huydinhischanging/mini-automotive-ecu-uds/README.md

# Mini Automotive ECU Network with UDS Diagnostics



A scaled-down model of an in-vehicle network: several ECUs talk over CAN, detect faults,
store diagnostic trouble codes (DTCs) and answer a diagnostic tester using **UDS (ISO 14229)**
over **ISO-TP (ISO 15765-2)**.

> 🚧 Work in progress. See [Roadmap](#roadmap) for current status.

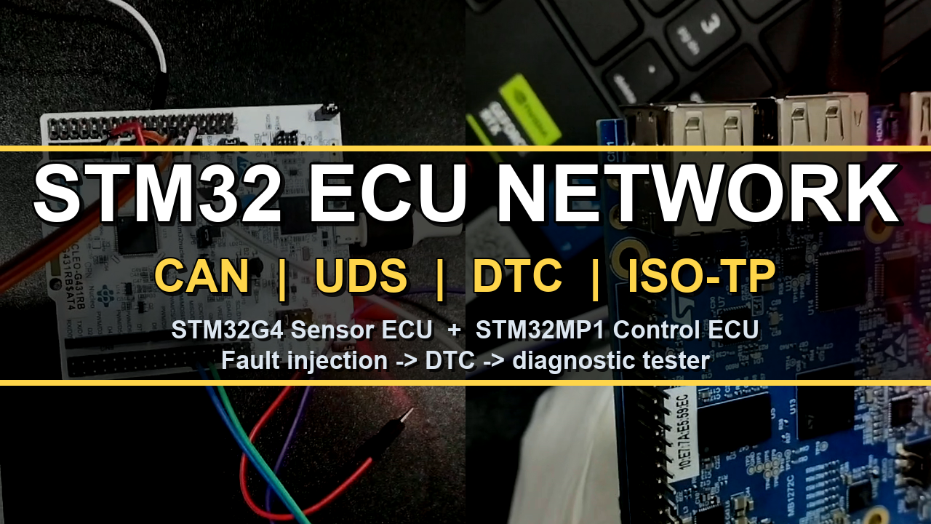
[picture p1: docs/images/demo_thumbnail.png]
Demo video: STM32 ECU network with CAN, UDS, DTC and ISO-TP (https://www.youtube.com/watch?v=Ocq1K0BO8kM)


▶ **Demo video (3 min):** https://www.youtube.com/watch?v=Ocq1K0BO8kM

> 📄 Technical report (milestones M1–M5): [docs/report/main.pdf](docs/report/main.pdf)

## System overview

```
 ┌──────────────────┐        CAN 500 kbit/s (Classic 2.0A)        ┌────────────────────────┐
 │  Sensor ECU      │═════════╦══════════════════════╦═════════════│  Control ECU           │
 │  NUCLEO-G431RB   │  0x100  ║                      ║  0x7E8      │  STM32MP157 Cortex-M4  │
 │  pot → ADC → CAN │  0x101  ║                      ║             │  FreeRTOS, DTC, UDS    │
 └──────────────────┘         ║                      ║             └────────────────────────┘
                              ║  0x7E0               ║
                     ┌────────╨──────────────────────╨───┐
                     │  Diagnostic Tester                │
                     │  today: UDS tester app on the     │
                     │  Sensor ECU (keys on its VCP)     │
                     └───────────────────────────────────┘
```

| Node | Hardware | Role |
|---|---|---|
| Sensor ECU | NUCLEO-G431RB + SN65HVD230 | Samples a potentiometer (simulated vehicle speed), sends it every 10 ms; also hosts the UDS tester (M5) |
| Control ECU | STM32MP157D-DK1, Cortex-M4 | Receives data, drives outputs, monitors faults, stores DTCs, UDS server |
| Tester (next) | STM32MP157D-DK1, Cortex-A7 (Linux) | C++ UDS client reaching the Control ECU over RPMsg (in progress) |

## CAN matrix

| ID | Sender → Receiver | Cycle | Content |
|---|---|---|---|
| `0x100` | Sensor → bus | 10 ms | Speed (0.1 km/h), raw ADC, status, alive counter, CRC-8 |
| `0x101` | Sensor → bus | 100 ms | Node state, uptime, bus-off count, alive counter, CRC-8 |
| `0x200` | Control ECU → bus | 100 ms | active faults, confirmed DTC count, output duty, alive counter, CRC-8 |
| `0x7E0` | Tester → Control ECU | on request | UDS request |
| `0x7E8` | Control ECU → Tester | on request | UDS response |

Signal-level layout: [`common/can/can_matrix.h`](common/can/can_matrix.h), compiled by both ECUs.
Cyclic frames carry an alive counter and a CRC-8 SAE-J1850 (same as AUTOSAR E2E Profile 1)
so the receiver can detect lost, repeated or corrupted frames.

**Bit timing:** 500 kbit/s, FDCAN kernel clock 170 MHz (from 24 MHz HSE crystal),
prescaler 10, 34 tq/bit (Seg1 29, Seg2 4, SJW 4) → sample point ≈ 88 %.

## Software architecture

Layered, AUTOSAR-inspired. Only the MCAL layer touches the HAL/registers.

```
Application    sensor_app, tester_app / control_app, diag_app
Services       uds_server, dtc_manager           (hardware independent)
Communication  isotp, e2e, crc8, can_matrix      (hardware independent)
MCAL           Sensor: can_drv, adc_drv, gpio_drv, uart_drv, time_drv
               Control: can_drv, io_drv, sys_drv
```

Hardware-independent modules (ISO-TP, UDS, DTC manager) are plain C so they can be unit
tested on a PC.

## UDS services (Control ECU, physical 0x7E0 / functional 0x7DF -> 0x7E8)

| SID | Service | Implemented |
|---|---|---|
| `0x10` | Diagnostic Session Control | `01` default, `03` extended; P2 = 50 ms, P2* = 5 s, S3 = 5 s |
| `0x11` | ECU Reset | `01` hard (firmware restart from the reset vector), `03` soft (new operation cycle); extended session only |
| `0x14` | Clear Diagnostic Information | group `FFFFFF` |
| `0x19` | Read DTC Information | `01` number of DTCs by status mask, `02` DTCs by status mask |
| `0x22` | Read Data By Identifier | `F195` SW version, `0100` speed, `0101` active faults; several DIDs per request |
| `0x3E` | Tester Present | `00`, with suppress-positive-response bit |

Negative responses `0x11`, `0x12`, `0x13`, `0x14`, `0x31`, `0x7E`, `0x7F`; for functional
requests the NRCs required by ISO 14229 are suppressed.

| Fault (monitor) | DTC | Confirmed after |
|---|---|---|
| Speed signal timeout | `U0100-87` (`C10087`) | 1 failed cycle |
| Speed out of range | `P0501-00` (`050100`) | 3 consecutive cycles |
| E2E error on 0x100 | `U0400-81` (`C40081`) | 3 |
| Sensor ADC error | `P0500-96` (`050096`) | 3 |
| Local output fault (USER1) | `B1A00-11` (`9A0011`) | 3 |

DTC status bits follow ISO 14229-1 Annex D (availability mask `0x7F`). Codes use the SAE J2012
layout; the mapping is project specific.

## Repository layout

```
sensor_ecu/          STM32CubeIDE project, NUCLEO-G431RB
  Core/Mcal/         can_drv, adc_drv, gpio_drv, uart_drv, time_drv
  Core/App/          sensor_app, tester_app (UDS tester)
control_ecu/CM4/     STM32MP157 Cortex-M4 firmware (FreeRTOS), loaded by Linux remoteproc
  Core/Mcal/         can_drv, io_drv (PWM output, USER1 button), sys_drv (restart)
  Core/App/          control_app, diag_app (ISO-TP link, UDS, DTC table)
  OPENAMP/           CubeMX-generated RPMsg glue (IPCC mailbox, resource table)
common/can/          CAN matrix shared by all nodes
common/e2e/          alive counter + CRC-8 protection (sender and receiver)
common/isotp/        ISO 15765-2 transport layer (SF/FF/CF/FC, BS, STmin, N_Bs/N_Cr timeouts)
common/uds/          UDS server (ISO 14229-1)
common/dtc/          DTC manager with ISO 14229 status bits
tests/               host unit tests (make)
tester/              C++20 UDS client, simulated ECU, GoogleTest (CMake)
tools/               check_all.sh, static_analysis.sh, arm_compile_check.sh, MISRA suppressions
docs/                report (LaTeX + PDF), logs, MISRA deviations, images
```

## Wiring (verified)

| Signal | NUCLEO-G431RB | SN65HVD230 | STM32MP157D-DK1 |
|---|---|---|---|
| FDCAN1_TX | PA12 = CN10 pin 12 (morpho) | CTX | PA12 = CN13 pin 9 (Arduino D14) |
| FDCAN1_RX | PA11 = CN10 pin 14 (morpho) | CRX | PA11 = CN13 pin 10 (Arduino D15) |
| Supply | 3V3 / GND (CN6) | 3V3 / GND | 3V3 = CN16 pin 4, GND = CN16 pin 6 |

Bus: CANH–CANH, CANL–CANL (twisted pair) and a common GND between both boards.
Each module carries a 120 Ω terminator, so CANH–CANL measures about 60 Ω with both connected.
On the DK1 use D14/D15 on CN13, not A4/A5; the same signals are also on the 40-pin CN2 (pins 3 and 5).

## Building and running the Sensor ECU

1. STM32CubeIDE → *File → Import → Existing Projects into Workspace* → select `sensor_ecu/`.
2. Build, then flash with the on-board ST-LINK.
3. Open the ST-LINK virtual COM port at 115200 8N1. A status line is printed every second:
   ```
   [SENSOR] speed=123.4 km/h adc=2021 mode=0 | tx=110 drop=0 rx=110 rx100=100 busoff=0
   ```

`SENSOR_APP_CAN_LOOPBACK` in `sensor_app.c` selects FDCAN internal loopback (no transceiver
needed) or normal mode (real bus).

**Fault injection:** the blue user button B1 cycles through
`NONE` → `SILENT` (stop sending 0x100, triggers timeout DTC) → `OUT_OF_RANGE` (300 km/h, triggers range DTC).

## Unit tests

Hardware-independent modules are tested on the PC with fake CAN driver and clock:

```
cd tests
make          # needs gcc (Linux, or MSYS2 UCRT64 on Windows)
```

## C++ UDS tester (`tester/`)

A UDS client in C++20 that will run on the DK1's Linux side and reach the Control ECU over
RPMsg. The client talks to an `ITransport` interface, so the same code runs against:

- `SimulatedEcu`: the **real C UDS server and DTC manager from `common/`** linked into the host
  program, so the client is tested against the code that runs on the M4;
- `RpmsgTransport` on the DK1 (next step).

```
cmake -S tester -B tester/build -G Ninja && cmake --build tester/build
ctest --test-dir tester/build          # GoogleTest
tester/build/uds_tester --sim          # same scenario as the M5 tester, against SimulatedEcu
```

GitHub Actions builds and runs the C unit tests (UBSan) and the C++ tests (ASan + UBSan) on
every push.

## Static analysis (cppcheck + MISRA C:2012)

Run all host checks (unit tests, static analysis, and a compile of both firmwares with
`arm-none-eabi-gcc`) in one go: `tools/check_all.sh`. The compile step uses the toolchain bundled
with STM32CubeIDE and is skipped if none is found; it can also be run on its own:
`tools/arm_compile_check.sh [FILE.c ...]`.

```
tools/static_analysis.sh      # cppcheck 2.x with the MISRA addon, exit 1 on findings
```

All project code (`common/`, App and MCAL layers of both ECUs) passes with **no findings**.
Nine rule violations were fixed in the code; the six remaining deviations (D1–D6) are documented in
[docs/misra_deviations.md](docs/misra_deviations.md).

## Milestones

### M1 — Sensor ECU bring-up (FDCAN internal loopback) ✅

NUCLEO-G431RB samples the potentiometer and publishes `0x100` (10 ms) and `0x101` (100 ms).
In FDCAN internal loopback the controller receives its own frames, which verifies bit-timing
configuration, acceptance filter, RX interrupt and frame packing without a transceiver.

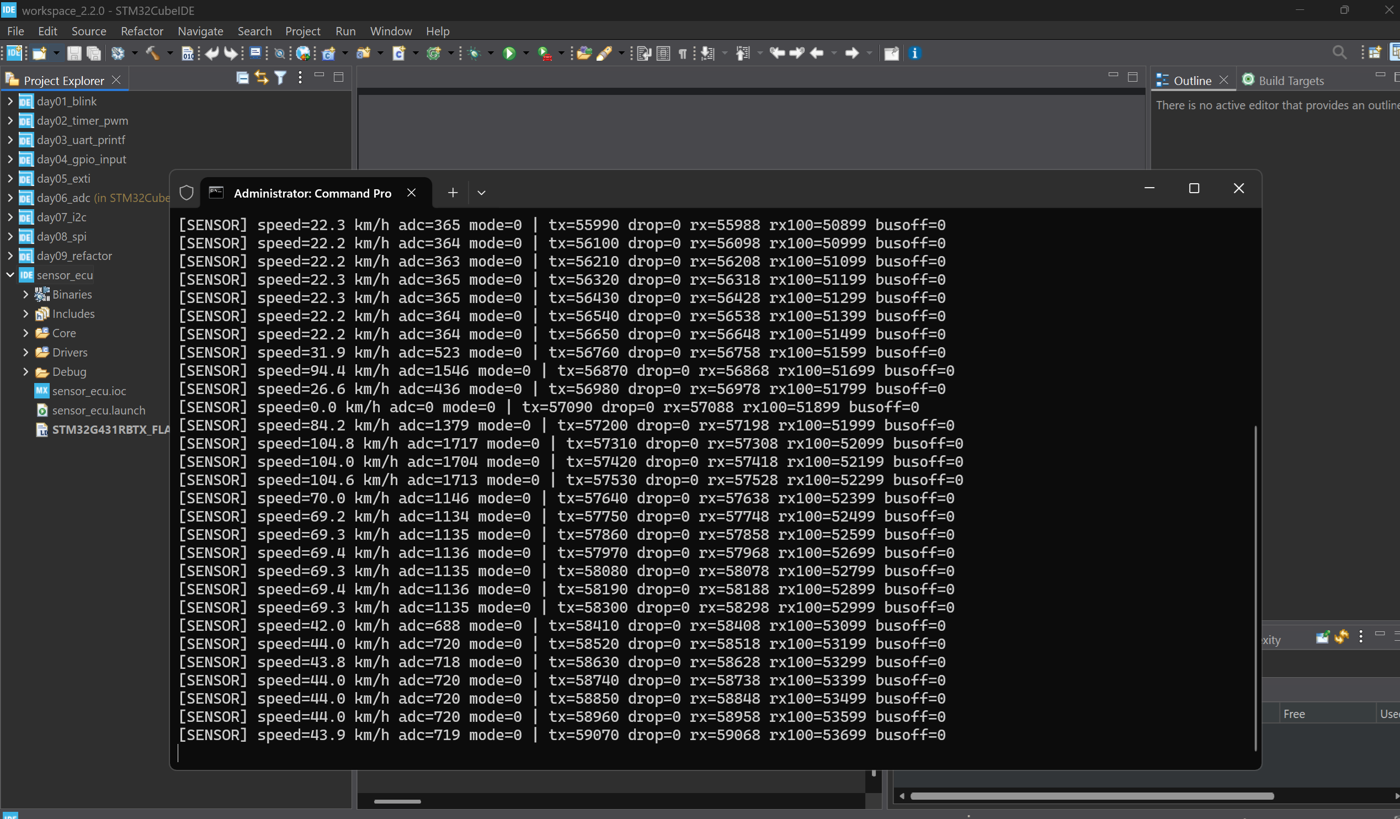
[picture p2: docs/images/m1_sensor_loopback_uart.png]
Sensor ECU UART log in internal loopback


| Check | Result |
|---|---|
| TX rate | 110 frames/s (100 × `0x100` + 10 × `0x101`) as designed |
| RX in loopback | every `0x100` received back (`rx100` +100/s) |
| Long run | 59 000+ frames, 0 dropped, 0 bus-off |
| ADC | full sweep follows the potentiometer, ±1–2 LSB noise at rest |
| Fault injection (B1) | verified on the real bus in M4 |

### M2 — Control ECU bring-up on the STM32MP157 Cortex-M4 (FDCAN internal loopback) ✅

The M4 firmware is loaded by Linux (remoteproc). In loopback it plays the Sensor ECU
(speed ramp 0–250 km/h) so the full receive chain is exercised on the DK1 alone:
FDCAN ISR → RTOS queue → E2E check → fault monitor → PWM output.

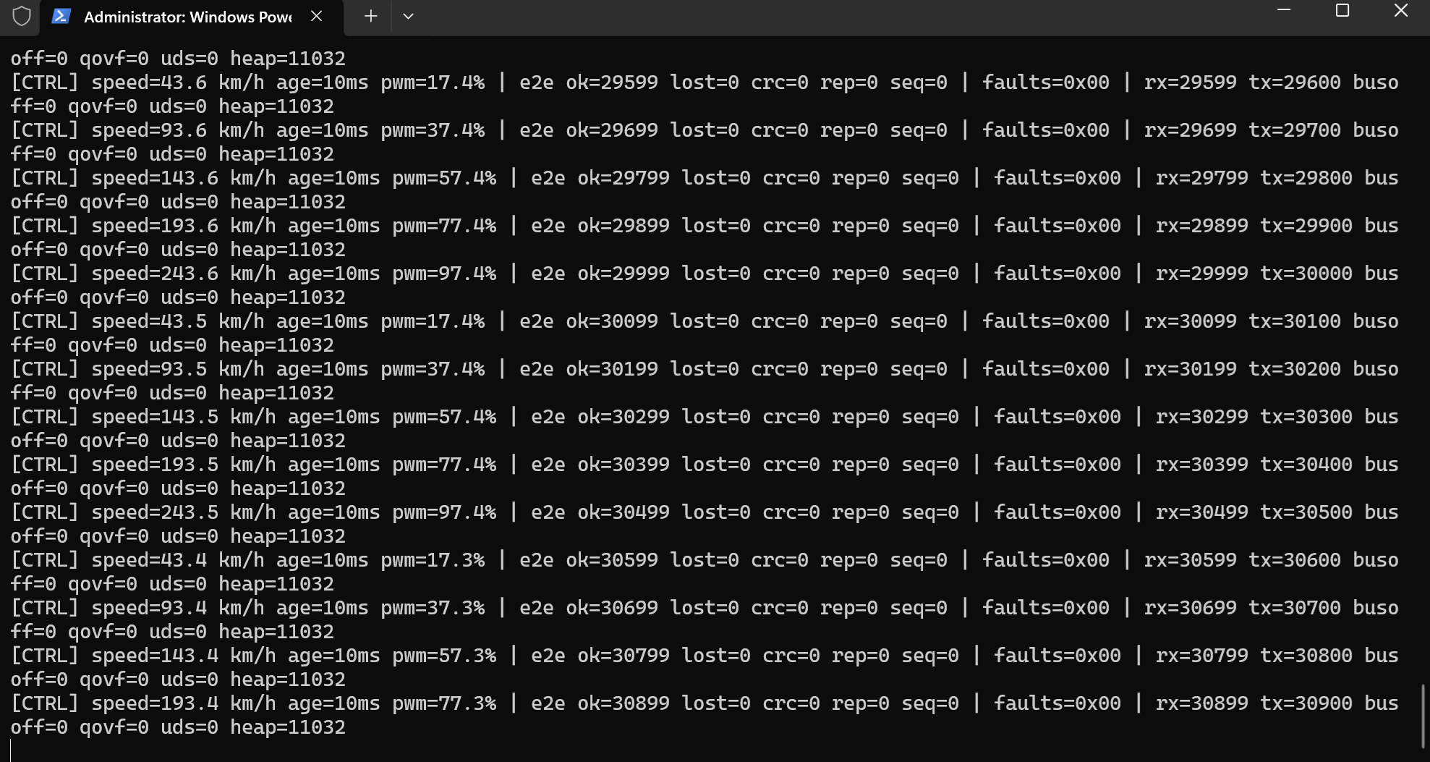
[picture p3: docs/images/m2_control_loopback_uart.png]
Control ECU UART log in internal loopback


| Check | Result |
|---|---|
| Throughput | 100 frames/s received, `rx = tx − 1` (last frame in flight) |
| Long run | 30 900 frames, 0 CRC / 0 lost / 0 repeated / 0 sequence errors |
| RTOS | 0 queue overflows, 11 KB of 16 KB heap free |
| Output | PWM follows speed (e.g. 193.4 km/h → 77.3 %), no active faults |
| Bring-up fixes | FreeRTOS SysTick handler, FDCAN glitch-free clock mux (see below) |

### M3 — UDS diagnostics and DTC management on the Control ECU (FDCAN internal loopback) ✅

A second ISO-TP link on the M4 plays the tester (TX 0x7E0, RX 0x7E8, BS 2, STmin 1 ms) and runs
14 UDS requests over the CAN controller, checking every response. Full log:
[docs/logs/m3_uds_selftest.log](docs/logs/m3_uds_selftest.log)

```
[TEST]  2/14 ReadDID F195 (ECU sends FF+CF)   PASS
[TEST]  3/14 ReadDID x4 (ECU receives FF+CF)  PASS
[TEST]  6/14 Reset in default -> NRC 7E       PASS
[CTRL] fault OUTPUT_LOCAL  SET
[TEST]  9/14 Confirmed DTCs = 1               PASS
[TEST] 10/14 DTC list B1A00-11 0x2F           PASS
[TEST] 11/14 Clear all DTCs                   PASS
[TEST] UDS self-test finished: 14/14 passed
```

Sensor data kept flowing during the test with 0 E2E errors and 0 queue overflows.

### M4 — Two-node CAN bus with fault injection ✅

NUCLEO-G431RB and STM32MP157D-DK1 on a real bus through two SN65HVD230 transceivers.
65 s capture of both ECUs, logs: [sensor](docs/logs/m4_bus_fault_injection_sensor.log),
[control](docs/logs/m4_bus_fault_injection_control.log)

| Time | Sensor ECU | Control ECU |
|---|---|---|
| 23–33 s | potentiometer sweep 142–233 km/h | speed and PWM follow |
| 39.7 s | B1 → `SILENT` (0x100 stopped) | 39.8 s `SPEED_TIMEOUT SET`, PWM 0 %, DTC U0100-87 |
| 46.7 s | B1 → `OUT_OF_RANGE` (300 km/h) | `SPEED_TIMEOUT cleared`, `SPEED_RANGE SET`, PWM 0 %, DTC P0501-00 |
| 55.6 s | B1 → normal | `SPEED_RANGE cleared`, PWM back to 64.5 %, DTCs retained |
| whole run | no dropped frame | 0 CRC / lost / repeated errors, 0 bus-off, 0 queue overflows |

Bring-up of the bus was diagnosed from the FDCAN error registers of both nodes: each node reading
back its own frames (LEC = ACK error) proved the MCU-transceiver wiring on each side, and putting the
DK1 into bus-monitoring (listen-only) mode proved that the bus polarity was correct.

### M5 — External UDS tester on the bus ✅

The Sensor ECU doubles as a UDS tester (shared ISO-TP module, TX 0x7E0 / RX 0x7E8), driven by
single keys on its ST-LINK virtual COM port (`t` test, `d` DTCs, `c` clear, `v` version+speed,
`f` functional 0x7DF, `r` hard reset). All **22 steps passed** over the physical bus; logs:
[tester](docs/logs/m5_uds_tester_sensor.log), [control ECU](docs/logs/m5_uds_tester_control.log).

```
[TESTER]  3/12 ReadDID 0100 speed                     PASS
        Control ECU speed 161.3 km/h, Sensor ECU sends 161.3 km/h
[TESTER]  8/12 Read all DTCs                          PASS
        2 DTC(s)
        U0100-87  status 0x2E pending confirmed
        U0400-81  status 0x2E pending confirmed
[TESTER]  2/2 Functional unknown service: silent     PASS
[TESTER]  2/4 ECUReset hard                          PASS
[TESTER]  3/4 ECU back: TesterPresent (after 3 s)    PASS
```

Hard reset finding: on the STM32MP157 in production mode, `NVIC_SystemReset()` leaves the M4 held
in reset (`RCC_MP_GCR.BOOT_MCU = 0`) because Linux owns its life cycle and is not informed. UDS
`0x11 01` therefore restarts the firmware from the reset vector (`SysDrv_Restart`) after resetting
the M4 peripherals, without resetting the core.

## Bring-up notes (STM32MP157 Cortex-M4)

Issues found while bringing up the Control ECU in production mode (Linux on the A7
starts the M4 through remoteproc). Diagnosed by reading M4 RAM and peripheral
registers from Linux (`/dev/mem`), without a debugger.

| Symptom | Root cause | Fix |
|---|---|---|
| FreeRTOS hangs on the first tick (`xTickCount = 0`) | CubeMX sets `USE_CUSTOM_SYSTICK_HANDLER_IMPLEMENTATION = 1` but generates no `SysTick_Handler` when TIM7 is the HAL timebase, so SysTick lands in `Default_Handler` | Override to `0` in the USER CODE section of `FreeRTOSConfig.h` so `cmsis_os2.c` provides the handler |
| FDCAN never leaves INIT (`CCCR.INIT` stuck at 1, even when cleared from Linux) | Linux leaves the FDCAN kernel mux on PLL4_R with that PLL output disabled. Kernel muxes are glitch-free and only switch while *both* inputs run, so the switch to HSE never completed | `CanDrv_PrepareKernelClock()`: enable HSE kernel output, briefly enable the old PLL output during the switch, restore it afterwards, read back the result |

Known open points:
- HAL tick (TIM7) runs at 2 kHz in production mode: the timer clock set by Linux differs
  from the CubeMX assumption. The application uses the FreeRTOS tick (correct 1 kHz).
- M4 log goes to UART7 (Arduino D0/D1). A remoteproc trace buffer (log readable over SSH)
  is planned as a cable-free alternative.

## Roadmap

- [x] Sensor ECU: CubeMX setup (170 MHz from HSE, FDCAN 500 kbit/s, ADC, TIM6 10 ms tick)
- [x] Sensor ECU: MCAL drivers, cyclic 0x100/0x101 with alive counter + CRC, bus-off recovery
- [x] Sensor ECU: verified in FDCAN internal loopback (M1)
- [ ] Sensor ECU: verify on the real bus with a logic analyzer
- [x] Control ECU: M4 firmware on OpenSTLinux (remoteproc), FDCAN owned by M4, FreeRTOS tasks,
      E2E check, timeout/range faults, safe-state PWM — verified in FDCAN internal loopback
- [x] M3: UDS server + DTC manager on the Control ECU, 14/14 on-target UDS self-test in loopback
- [x] M4: two-node bus, 100 frames/s with 0 E2E errors, 0x200 status back to the Sensor ECU, fault injection -> DTCs
- [ ] Logic analyzer capture of bit timing on the bus
- [ ] E2E fault injection on the Sensor ECU (corrupted CRC, repeated counter, counter jump) to exercise
      the Control ECU's E2E monitor and DTC `U0400-81` on the bus
- [x] ISO-TP (SF, FF, CF, FC, block size, STmin, timeouts) with 26 host unit tests
- [x] UDS server with services above (11 host unit tests)
- [x] DTC manager (ISO 14229 status bits, debounce, operation cycle; 11 host unit tests)
- [x] M5: external UDS tester on the Sensor ECU, 22/22 steps over the bus incl. hard reset
- [x] C++ UDS client (C++20, CMake, GoogleTest) verified against the real UDS server in simulation
- [ ] C++ UDS tester on Linux (Cortex-A7) over RPMsg: IPCC + OpenAMP enabled on the M4, RPMsg bridge next
- [x] Host unit tests: 56 tests / 277 checks (ISO-TP, E2E, DTC, UDS)
- [x] cppcheck + MISRA C:2012 addon: no findings, deviations documented
- [x] Demo video: https://www.youtube.com/watch?v=Ocq1K0BO8kM
