huydinhischanging/mini-automotive-ecu-uds/docs/report/before_main/title.tex

\begin{titlepage}
    \begin{center}
        \vspace*{2.5cm}

        \Large
        PERSONAL PROJECT REPORT

        \vspace{2.0cm}

        \Huge
        \textbf{Mini Automotive ECU Network with UDS Diagnostics}\\[0.8cm]
        \Large
        CAN communication, end-to-end protection and ISO-TP on an\\
        STM32G4 Sensor ECU and an STM32MP157 Control ECU

        \vspace{2.4cm}

        \Large
        By\\
        \textbf{Tu Dinh Huy}

        \vspace{1.2cm}

        \large
        Interim report -- milestones M1 to M5\\[0.3cm]
        Source code: \url{https://github.com/huydinhischanging/mini-automotive-ecu-uds}\\[0.1cm]
        Demo video: \url{https://www.youtube.com/watch?v=Ocq1K0BO8kM}

        \vfill
        Ho Chi Minh City, Vietnam\\
        September 2026

    \end{center}
\end{titlepage}
