huydinhischanging/mini-automotive-ecu-uds/docs/report/before_main/abstract.tex

\chapter*{ABSTRACT}
\addcontentsline{toc}{chapter}{ABSTRACT}

This report describes the design and the first four milestones of a scaled-down in-vehicle network built from low-cost development boards. A \textit{Sensor ECU} on an STM32G431 (NUCLEO-G431RB) samples a potentiometer that emulates vehicle speed and publishes it on a 500\,kbit/s classic CAN bus every 10\,ms. A \textit{Control ECU} runs FreeRTOS on the Cortex-M4 core of an STM32MP157D (STM32MP157D-DK1), next to Linux on the Cortex-A7 cores, and consumes the signal, monitors it for faults and drives a PWM output. A diagnostic tester using UDS (ISO~14229) over ISO-TP (ISO~15765-2) completes the target architecture.

The software follows an AUTOSAR-inspired layering in which only the MCAL layer touches the vendor HAL. Protocol and service modules (ISO-TP, end-to-end protection with an alive counter and CRC-8 SAE-J1850, a UDS server and a DTC manager with ISO~14229 status bits) are written in portable C and are tested on a PC with a small test harness: 56 unit tests with 277 checks pass, including a 4095-byte ISO-TP transfer between two protocol instances.

Both ECUs were verified on hardware in FDCAN internal loopback. The Sensor ECU sent more than 59\,000 frames at the designed 110\,frames/s with no dropped frame and no bus-off; the ADC reading was stable to $\pm$1--2\,LSB. The Control ECU processed 30\,900 frames with zero CRC, sequence or queue-overflow errors while its output tracked the received speed. Bringing up the Control ECU uncovered two platform issues that were diagnosed by reading M4 memory and peripheral registers from Linux, without a hardware debugger: a SysTick handler missing from STM32CubeMX-generated code, and an FDCAN kernel clock stuck in a glitch-free multiplexer whose previous input had been disabled by Linux.

The diagnostic stack was then integrated on the Control ECU: monitor results become DTCs, and a tester running on the same Cortex-M4 exchanged 14 UDS requests with the ECU over the CAN controller, covering segmented ISO-TP transfers in both directions, negative responses, session handling and reading and clearing a confirmed DTC; all 14 passed on hardware.

Finally, both ECUs were connected through SN65HVD230 transceivers. On the physical bus the Control ECU received 100 frames/s with zero end-to-end errors and no bus-off, detected an injected loss of the speed signal within about 100\,ms and an out-of-range value immediately, drove its output to the safe state and stored the corresponding DTCs, which remained stored after the faults healed. An external UDS tester running on the Sensor ECU then exercised the Control ECU over the physical bus in 22 steps, all passing, including a hard reset; this uncovered that a Cortex-M4 system reset on the STM32MP157 leaves the core held in reset under Linux, which was solved with a software restart from the reset vector. The remaining work is a Linux-side tester and a logic-analyser measurement of the bus timing.

\bigskip
\noindent\textbf{Keywords:} Controller Area Network, ISO-TP, UDS, DTC, AUTOSAR E2E, STM32MP157, FreeRTOS, embedded C, unit testing.
\newpage
