huydinhischanging/mini-automotive-ecu-uds/docs/report/before_main/abbreviations.tex

\chapter*{LIST OF ABBREVIATIONS}
\addcontentsline{toc}{chapter}{LIST OF ABBREVIATIONS}

{\small
\renewcommand{\arraystretch}{0.9}
\begin{longtable}{@{}p{3.2cm} p{11cm}@{}}
\textbf{ACK}      & Acknowledge (CAN bit acknowledging a correctly received frame) \\
\textbf{ADC}      & Analog-to-Digital Converter \\
\textbf{AUTOSAR}  & AUTomotive Open System ARchitecture \\
\textbf{BS}       & Block Size (ISO-TP flow-control parameter) \\
\textbf{CAN}      & Controller Area Network \\
\textbf{CCU}      & Clock Calibration Unit (of FDCAN1 on the STM32MP1) \\
\textbf{CF}       & Consecutive Frame (ISO-TP) \\
\textbf{CRC}      & Cyclic Redundancy Check \\
\textbf{DLC}      & Data Length Code \\
\textbf{DTC}      & Diagnostic Trouble Code \\
\textbf{E2E}      & End-to-End (communication protection) \\
\textbf{ECU}      & Electronic Control Unit \\
\textbf{FC}       & Flow Control frame (ISO-TP) \\
\textbf{FDCAN}    & Flexible Data-rate CAN controller (ST implementation of Bosch M\_CAN) \\
\textbf{FF}       & First Frame (ISO-TP) \\
\textbf{HAL}      & Hardware Abstraction Layer (STM32Cube) \\
\textbf{HSE}      & High-Speed External oscillator \\
\textbf{HSI}      & High-Speed Internal RC oscillator \\
\textbf{ISO-TP}   & ISO 15765-2 transport protocol \\
\textbf{ISR}      & Interrupt Service Routine \\
\textbf{LSB}      & Least Significant Bit \\
\textbf{MCAL}     & Microcontroller Abstraction Layer (AUTOSAR) \\
\textbf{MCU}      & Microcontroller Unit \\
\textbf{MPU}      & Microprocessor Unit \\
\textbf{NBT}      & Nominal Bit Time, in time quanta \\
\textbf{NRC}      & Negative Response Code (UDS) \\
\textbf{PLL}      & Phase-Locked Loop \\
\textbf{PWM}      & Pulse-Width Modulation \\
\textbf{RTOS}     & Real-Time Operating System \\
\textbf{SF}       & Single Frame (ISO-TP) \\
\textbf{SJW}      & Synchronisation Jump Width \\
\textbf{SP}       & Sample Point \\
\textbf{STmin}    & Minimum Separation Time between consecutive frames (ISO-TP) \\
\textbf{tq}       & Time quantum \\
\textbf{UART}     & Universal Asynchronous Receiver-Transmitter \\
\textbf{UDS}      & Unified Diagnostic Services (ISO 14229) \\
\end{longtable}
}
\pagebreak
