huydinhischanging/mini-automotive-ecu-uds/docs/report/main.pdf

## PERSONAL PROJECT REPORT

# Mini Automotive ECU Network with UDS Diagnostics

## CAN communication, end-to-end protection and ISO-TP on an STM32G4 Sensor ECU and an STM32MP157 Control ECU

By

## Tu Dinh Huy

### Interim report – milestones M1 to M5

### Source code: https://github.com/huydinhischanging/mini-automotive-ecu-uds Demo video: https://www.youtube.com/watch?v=Ocq1K0BO8kM

### Ho Chi Minh City, Vietnam September 2026

# TABLE OF CONTENTS

LIST OF FIGURES | 3
LIST OF TABLES | 4
LIST OF ABBREVIATIONS | 5
ABSTRACT | 6
1 INTRODUCTION | 7
2 TECHNICAL BACKGROUND | 9
3 SYSTEM DESIGN | 12

4 IMPLEMENTATION AND RESULTS | 20

4.9.2 Issue 2: FDCAN kernel clock stuck in a glitch-free multiplexer . . . 28

5 DISCUSSION AND EVALUATION | 30
6 CONCLUSION AND FUTURE WORK | 33
REFERENCES | 35
Appendices | 36
A Frame Layouts | 36
B Build, Deployment and Diagnosis Procedures | 37

# LIST OF FIGURES

2.1 | Segmented ISO-TP transfer of a 20-byte message | 10
3.1 | Target network architecture. The dashed tester link is future work | 13
3.2 | AUTOSAR-inspired software layers | 15
3.3 | Control ECU data flow | 16
4.1 | Sensor ECU log in FDCAN internal loopback (one line per second) | 22
4.2 | Control ECU log on the STM32MP157 Cortex-M4 in FDCAN internal loopback 23

# LIST OF TABLES

1.1 | Project status at the time of writing | | 8
3.1 | System requirements | 12
3.2 | Hardware | 13
3.3 | Bit-timing configuration (500 kbit/s) | 13
3.4 | CAN matrix | 14
3.5 | Faults monitored by the Control ECU | 16
3.6 | Implemented UDS services | 17
3.7 | DTC mapping of the Control ECU | 18
4.1 | Tools | 20
4.2 | Unit test results | 21
4.3 | Milestone M1 results | 22
4.4 | Milestone M2 results | 23
4.5 | Milestone M3 results | 24
4.6 | Verified bus wiring | 24
4.7 | Milestone M4: fault injection over the physical bus | 25
4.8 | Milestone M5: UDS from an external node | 26
4.9 | Handling of the static-analysis findings | 27
4.10 FDCAN clock state left by Linux after boot | 28
4.11 Memory footprint (Debug builds) | 29
5.1 Requirement coverage | 30
A.1 Frame 0x100 SENSOR_SPEED (DLC 8, 10 ms) | 36
A.2 Frame 0x101 SENSOR_ALIVE (DLC 8, 100 ms) | 36

# LIST OF ABBREVIATIONS

ACK | Acknowledge (CAN bit acknowledging a correctly received frame)
ADC | Analog-to-Digital Converter
AUTOSAR | AUTomotive Open System ARchitecture
BS | Block Size (ISO-TP flow-control parameter)
CAN | Controller Area Network
CCU | Clock Calibration Unit (of FDCAN1 on the STM32MP1)
CF | Consecutive Frame (ISO-TP)
CRC | Cyclic Redundancy Check
DLC | Data Length Code
DTC | Diagnostic Trouble Code
E2E | End-to-End (communication protection)
ECU | Electronic Control Unit
FC | Flow Control frame (ISO-TP)
FDCAN | Flexible Data-rate CAN controller (ST implementation of Bosch
| M_CAN)
FF | First Frame (ISO-TP)
HAL | Hardware Abstraction Layer (STM32Cube)
HSE | High-Speed External oscillator
HSI | High-Speed Internal RC oscillator
ISO-TP | ISO 15765-2 transport protocol
ISR | Interrupt Service Routine
LSB | Least Significant Bit
MCAL | Microcontroller Abstraction Layer (AUTOSAR)
MCU | Microcontroller Unit
MPU | Microprocessor Unit
NBT | Nominal Bit Time, in time quanta
NRC | Negative Response Code (UDS)
PLL | Phase-Locked Loop
PWM | Pulse-Width Modulation
RTOS | Real-Time Operating System
SF | Single Frame (ISO-TP)
SJW | Synchronisation Jump Width
SP | Sample Point
STmin | Minimum Separation Time between consecutive frames (ISO-TP)
tq | Time quantum
UART | Universal Asynchronous Receiver-Transmitter
UDS | Unified Diagnostic Services (ISO 14229)

# ABSTRACT

This report describes the design and the first four milestones of a scaled-down in-vehicle network built from low-cost development boards. A Sensor ECU on an STM32G431 (NUCLEO-G431RB) samples a potentiometer that emulates vehicle speed and publishes it on a 500 kbit/s classic CAN bus every 10 ms. A Control ECU runs FreeRTOS on the Cortex-M4 core of an STM32MP157D (STM32MP157D-DK1), next to Linux on the Cortex-A7 cores, and consumes the signal, monitors it for faults and drives a PWM output. A diagnostic tester using UDS (ISO 14229) over ISO-TP (ISO 15765-2) completes the target architecture.
The software follows an AUTOSAR-inspired layering in which only the MCAL layer touches the vendor HAL. Protocol and service modules (ISO-TP, end-to-end protection with an alive counter and CRC-8 SAE-J1850, a UDS server and a DTC manager with ISO 14229 status bits) are written in portable C and are tested on a PC with a small test harness: 56 unit tests with 277 checks pass, including a 4095-byte ISO-TP transfer between two protocol instances.
Both ECUs were verified on hardware in FDCAN internal loopback. The Sensor ECU sent more than 59 000 frames at the designed 110 frames/s with no dropped frame and no bus-off; the ADC reading was stable to ±1–2 LSB. The Control ECU processed 30 900 frames with zero CRC, sequence or queue-overflow errors while its output tracked the received speed. Bringing up the Control ECU uncovered two platform issues that were diagnosed by reading M4 memory and peripheral registers from Linux, without a hardware debugger: a SysTick handler missing from STM32CubeMX-generated code, and an FDCAN kernel clock stuck in a glitch-free multiplexer whose previous input had been disabled by Linux.
The diagnostic stack was then integrated on the Control ECU: monitor results become DTCs, and a tester running on the same Cortex-M4 exchanged 14 UDS requests with the ECU over the CAN controller, covering segmented ISO-TP transfers in both directions, negative responses, session handling and reading and clearing a confirmed DTC; all 14 passed on hardware.
Finally, both ECUs were connected through SN65HVD230 transceivers. On the physical bus the Control ECU received 100 frames/s with zero end-to-end errors and no bus-off, detected an injected loss of the speed signal within about 100 ms and an outof-range value immediately, drove its output to the safe state and stored the corresponding DTCs, which remained stored after the faults healed. An external UDS tester running on the Sensor ECU then exercised the Control ECU over the physical bus in 22 steps, all passing, including a hard reset; this uncovered that a Cortex-M4 system reset on the STM32MP157 leaves the core held in reset under Linux, which was solved with a software restart from the reset vector. The remaining work is a Linux-side tester and a logic-analyser measurement of the bus timing.

Keywords: Controller Area Network, ISO-TP, UDS, DTC, AUTOSAR E2E, STM32MP157, FreeRTOS, embedded C, unit testing.

# Chapter 1

# INTRODUCTION

## 1.1 Background

A modern vehicle contains dozens of electronic control units (ECUs) that exchange data over in-vehicle networks, most commonly the Controller Area Network (CAN) [1]. Each ECU samples sensors, runs control software and, just as importantly, supervises itself: it detects missing or implausible signals, stores diagnostic trouble codes (DTCs) and answers a workshop tester through a standardised diagnostic protocol, Unified Diagnostic Services (UDS) [2]. Because a CAN frame carries at most eight data bytes, diagnostic messages travel over the ISO-TP transport layer, which segments and reassembles longer messages [3].
These building blocks, deterministic communication, end-to-end protection of safetyrelevant signals, fault management and diagnostics, are the daily material of automotive embedded software. They are rarely visible in hobby projects, which usually stop at reading a sensor and blinking a LED.

## 1.2 Problem Statement and Motivation

Professional automotive tool chains (AUTOSAR stacks, commercial CAN analysers, production ECUs) are expensive and hide most of the mechanisms behind configuration tools. A learner therefore has few opportunities to implement and debug the protocols end to end on real hardware. The goal of this project is to build a miniature but technically faithful ECU network from affordable development boards, implementing the protocols from the standards rather than from vendor black boxes, and to document the engineering decisions in a way that can be reviewed.

## 1.3 Objectives

O1. Build a two-ECU classic CAN network at 500 kbit/s with a correct, justified bit-timing configuration on two different STM32 families.

O2. Protect the cyclic sensor signal end to end (alive counter and CRC) and detect timeout, out-of-range and corrupted data at the receiver, with a defined safe state.

O3. Implement ISO-TP and a UDS server (sessions, tester present, read data by identifier, read and clear DTCs, ECU reset, negative responses) on the Control ECU.

O4. Structure the firmware in AUTOSAR-like layers so that protocol code is hardware independent and unit tested on a PC.

O5. Run the Control ECU on the Cortex-M4 of a heterogeneous STM32MP157, alongside Linux, as in modern domain controllers.

## 1.4 Scope of this Report

This is an interim report. Table 1.1 summarises what is complete and verified at the time of writing. All results in Chapter 4 refer to the completed items only; the remaining items are described as design and future work.

Table 1.1: Project status at the time of writing

Work item | Evidence | Status
Sensor ECU firmware (ADC, cyclic CAN, E2E, fault injection) | M1 hardware test | ✓
ISO-TP transport layer | 26 unit tests | ✓
E2E protection library (shared by both ECUs) | 8 unit tests | ✓
Control ECU firmware on the Cortex-M4 (FreeRTOS, E2E check, fault monitor, safe- state output) | M2 hardware test | ✓
UDS server and DTC manager | 22 unit tests, M3 on-target self-test, M5
external tester

✓

Two-node | physical | CAN | bus | with
transceivers, fault injection
M4 hardware test | ✓
Python tester on Linux (SocketCAN) | – | planned
Static analysis (cppcheck with MISRA
C:2012 addon)
no findings, 6 documented deviations | ✓
Demo video (3 min) | published on YouTube | ✓

## 1.5 Report Structure

Chapter 2 reviews the relevant protocols and the STM32MP1 heterogeneous architecture. Chapter 3 presents the hardware, the CAN configuration and the software design of both ECUs. Chapter 4 reports the implementation, the unit tests and the two hardware milestones, including the diagnosis of two bring-up issues. Chapter 5 evaluates the results against the objectives and discusses limitations, and Chapter 6 concludes with the remaining work. The appendices contain the frame layouts and the build and diagnosis procedures.

# Chapter 2

# TECHNICAL BACKGROUND

This chapter summarises the standards and platform features that the design relies on. It is not a complete tutorial; the cited specifications are normative.

## 2.1 Controller Area Network

CAN is a multi-master serial bus with non-destructive bitwise arbitration: when several nodes start transmitting, the frame with the lowest identifier wins and the others retry automatically [1], [4]. Every receiver acknowledges a correct frame in the ACK slot, so a transmitter that is alone on the bus sees an acknowledgement error and keeps retrying. Each node maintains transmit and receive error counters; above 255 transmit errors it enters the bus-off state and stops participating until it has observed 128 occurrences of 11 recessive bits.

### 2.1.1 Bit timing

A bit is divided into time quanta (tq) of length tq = prescaler/fkernel. The nominal bit time is
NBT = 1 + Seg1 + Seg2 [tq], bitrate =

fkernel
prescaler · NBT, | (2.1)

where the leading quantum is the synchronisation segment, Seg1 combines propagation and phase segment 1, and Seg2 is phase segment 2. The bus is sampled at the sample point
SP =

1 + Seg1
NBT , | (2.2)

for which automotive networks typically use about 87.5 %. The synchronisation jump width (SJW) limits how far a node may re-align its bit phase on each recessive-to-dominant edge. Because every node samples with its own oscillator, the tolerated clock deviation is bounded by [1]
∆f ≤ min (
SJW
20 NBT,

min(Seg1, Seg2)
2 (13 NBT − Seg2)

)
. | (2.3)

For the configurations in this project the bound is below 0.5 %, which rules out on-chip RC oscillators (typically ±1 %) and motivates crystal clocks on both ECUs.

## 2.2 ISO-TP (ISO 15765-2)

ISO-TP transports messages of up to 4095 bytes over classic CAN frames [3]. The first byte (protocol control information) identifies four frame types:
- Single Frame (SF) 0L: up to 7 data bytes.
- First Frame (FF) 1L LL: 12-bit total length and 6 data bytes.
- Consecutive Frame (CF) 2N: 7 data bytes with a 4-bit sequence number that wraps from 15 to 0.
- Flow Control (FC) 3S BS STmin: sent by the receiver with a flow status (continue, wait, overflow), a block size BS (number of CFs before the next FC, 0 = unlimited) and the minimum separation time STmin between CFs.
Timers supervise the exchange: the sender waits at most N_Bs for a flow control, the receiver at most N_Cr for the next consecutive frame. Figure 2.1 shows a segmented

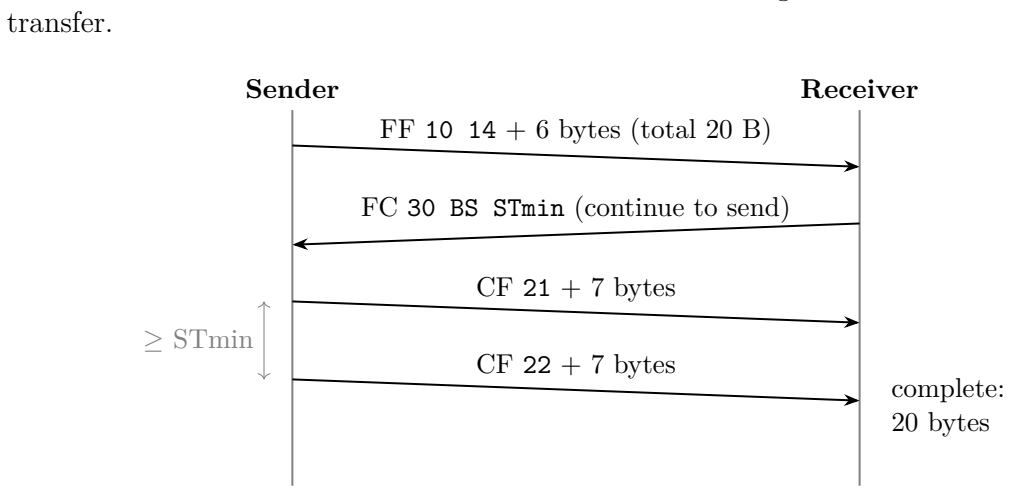
[picture p4: figure]
transfer.; Sender; Receiver; FF 10 14 + 6 bytes (total 20 B); FC 30 BS STmin (continue to send); CF 21 + 7 bytes; CF 22 + 7 bytes; complete: 20 bytes; ≥ STmin

Figure 2.1: Segmented ISO-TP transfer of a 20-byte message

## 2.3 Unified Diagnostic Services (ISO 14229)

UDS defines a request/response protocol between a tester and an ECU [2]. A request starts with a service identifier (SID); a positive response echoes SID + 0x40, and a negative response is 7F SID NRC with a negative response code such as 0x11 (service not supported) or 0x31 (request out of range). The services targeted by this project are Diagnostic Session Control (0x10), ECU Reset (0x11), Clear Diagnostic Information (0x14), Read DTC Information (0x19), Read Data By Identifier (0x22) and Tester Present (0x3E). On vehicles the physical request and response identifiers of the engine ECU are commonly 0x7E0 and 0x7E8; the project reuses this pair.

## 2.4 End-to-End Protection

Bus-level CAN checks detect transmission errors on the wire but not faults inside an ECU, such as a stuck task that keeps resending an old buffer or corrupted RAM. AUTOSAR E2E profiles therefore add, inside the payload, an alive (sequence) counter and a CRC computed by the sender and verified by the receiver [5]. Profile 1 uses a 4-bit counter and CRC-8 SAE-J1850 (polynomial 0x1D) [6]. The receiver classifies each frame as correct, repeated, with some frames lost, or with a wrong sequence, and discards data that fails the check.

## 2.5 Layered ECU Software

The AUTOSAR classic platform separates application software from basic software, and at the bottom of the basic software the microcontroller abstraction layer (MCAL) encapsulates all register access [7]. This project applies the same idea at a small scale: only MCAL drivers call the STM32 HAL; communication and service modules are portable C.

## 2.6 STM32MP157 Heterogeneous Architecture

The STM32MP157 combines two Cortex-A7 cores running Linux with a Cortex-M4 microcontroller core [8]. In the production boot mode used here, Linux starts first, owns the clock tree and loads the M4 firmware from the file system through the remoteproc framework. The M4 has no flash of its own; its code runs from internal SRAM and must be reloaded after each power cycle. Peripherals are assigned to one of the cores; a peripheral assigned to the M4 is disabled in the Linux device tree, but its kernel clock is still generated by the reset and clock controller (RCC), whose settings are left by Linux. This division of responsibilities is central to the bring-up issues analysed in Section 4.9.

# Chapter 3

# SYSTEM DESIGN

## 3.1 Requirements

Table 3.1 lists the requirements derived from the objectives in Chapter 1. They are referenced in the evaluation in Chapter 5.

Table 3.1: System requirements

ID Requirement

R1 Classic CAN 2.0A, 11-bit identifiers, 500 kbit/s, sample point close to 87.5 % on every node.
R2 The Sensor ECU publishes the speed signal every 10 ms and a node heartbeat every 100 ms. R3 Cyclic frames carry an alive counter and a CRC; the receiver rejects corrupted, repeated and out-of-sequence data.
R4 The Control ECU detects a missing speed signal within 100 ms, an out-of-range speed and an E2E error, and then drives its output to a safe state (0 %).
R5 Fault injection on both ECUs by push button, without changing wiring.
R6 Diagnostic access through UDS over ISO-TP on 0x7E0/0x7E8, with negative responses. R7 Only the MCAL layer accesses the HAL; protocol modules are hardware independent and unit tested on a PC.
R8 Bus-off is recovered automatically after a delay, without resetting the ECU.

## 3.2 System Architecture and Hardware

Figure 3.1 shows the target network. Table 3.2 lists the hardware.

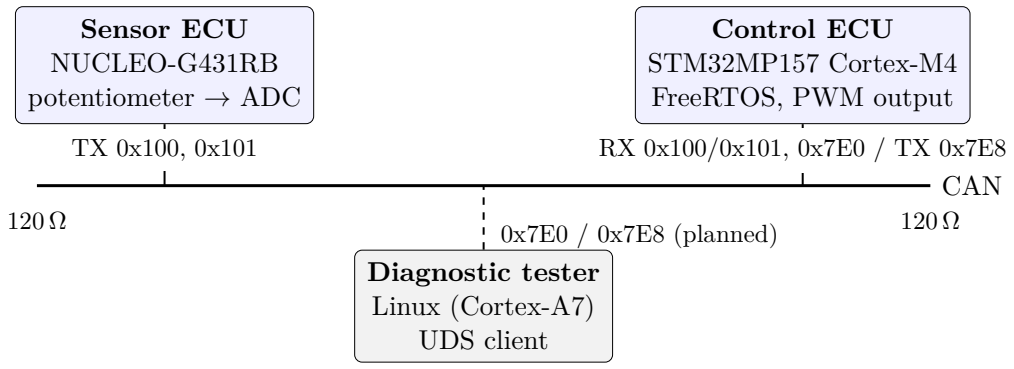
[picture p5: figure]
Sensor ECU NUCLEO-G431RB potentiometer → ADC; Control ECU STM32MP157 Cortex-M4 FreeRTOS, PWM output; Diagnostic tester Linux (Cortex-A7) UDS client; CAN; 0x7E0 / 0x7E8 (planned) 120 Ω

TX 0x100, 0x101 | RX 0x100/0x101, 0x7E0 / TX 0x7E8

Figure 3.1: Target network architecture. The dashed tester link is future work.

Table 3.2: Hardware

Item | Use

NUCLEO-G431RB (STM32G431RB, Cortex-M4F, 170 MHz) [9], [10]

Sensor ECU; on-board ST-LINK for flashing and a virtual COM port for logs
STM32MP157D-DK1 (2×Cortex-A7 + Cortex-M4) [8], [11]

Control ECU on the M4, Linux (Open-STLinux, kernel 6.6) on the A7 cores
SN65HVD230 3.3 V CAN transceiver (2×) [12] | Physical layer; 3.3 V parts avoid level
shifting on 3.3 V MCU pins
10 kΩ potentiometer, push buttons, LED + 220 Ω | Speed input, fault injection, PWM
output
USB-to-UART adapter | Log of the M4 firmware (UART7)

## 3.3 CAN Configuration

### 3.3.1 Bit timing

The two controllers run from different kernel clocks, so each node has its own timing. Both are derived from a crystal (HSE) because the tolerance bound of Equation 2.3 is below 0.5 % for both configurations. Table 3.3 gives the values.

Table 3.3: Bit-timing configuration (500 kbit/s)

Sensor ECU (G431) Control ECU (MP157)
Kernel clock | 170 MHz (PCLK1)a | 24 MHz (HSE)
Prescaler | 10 | 3
tq | 58.8 ns | 125 ns
Seg1 / Seg2 / SJW | 29 / 4 / 4 | 13 / 2 / 2
NBT | 34 tq | 16 tq
Bit rate | 500 000 bit/s | 500 000 bit/s
Sample point | 88.2 % | 87.5 %
Tolerance bound (Eq. 2.3) | 0.46 % | 0.49 %
a PLL from the 24 MHz HSE crystal.

On the STM32G431, 170 MHz cannot be divided into a 16-quantum bit at 500 kbit/s, so 34 tq were used; the resulting 88.2 % sample point is within a fraction of a quantum of 87.5 %. On the STM32MP157 the 24 MHz HSE gives exactly 16 tq and 87.5 %. The kernel clock that Linux selects by default (PLL4_R, 74.25 MHz) cannot produce 500 kbit/s exactly (74.25 MHz/500 kHz = 148.5); the Control ECU therefore switches the FDCAN kernel clock to HSE at start-up (Section 4.9) and keeps a fallback timing for 74.25 MHz with a 0.34 % error.

### 3.3.2 CAN matrix

Table 3.4 lists the identifiers. The byte layout is defined once in common/can/can_-matrix.h, which both firmware projects compile, so the layouts cannot drift apart. The detailed layout is in Appendix A.

Table 3.4: CAN matrix

ID | Name | Sender | Cycle Content
0x100 | SENSOR_SPEED | Sensor ECU | 10 ms | speed (0.1 km/h), raw ADC, status, alive counter, CRC-8
0x101 | SENSOR_ALIVE | Sensor ECU | 100 ms node state, uptime, bus-off count,
| | | | alive counter, CRC-8
0x200 | CONTROL_STATUS Control ECU 100 ms active faults, confirmed DTC count,
| | | | output duty, alive counter, CRC-8
0x7E0 UDS request | tester | event | ISO-TP, physical addressing to the
| | | | Control ECU
0x7E8 UDS response | Control ECU | event | ISO-TP response

Multi-byte signals are big-endian (Motorola byte order), as is usual in automotive signal databases, and the speed is an unsigned integer in 0.1 km/h so that no floatingpoint value travels on the bus.

## 3.4 Software Architecture

Figure 3.2 shows the layering. MCAL drivers wrap the STM32 HAL; everything above them is portable C. The shared modules in common/ are linked into both STM32CubeIDE projects as a linked folder, so the firmware and the PC unit tests compile the very same source files.

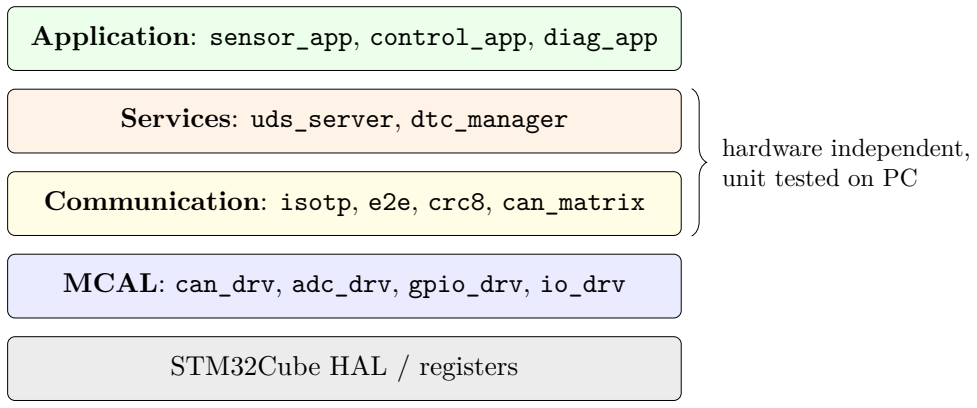
[picture p6: figure]
Application: sensor_app, control_app, diag_app; Services: uds_server, dtc_manager; Communication: isotp, e2e, crc8, can_matrix; MCAL: can_drv, adc_drv, gpio_drv, io_drv; STM32Cube HAL / registers; hardware independent, unit tested on PC

Figure 3.2: AUTOSAR-inspired software layers

## 3.5 Sensor ECU Design

The Sensor ECU runs bare-metal. TIM6 raises a flag every 10 ms; the main loop consumes it and runs one task cycle. The interrupt routine only sets the flag, so ADC conversions, CAN writes and logging never execute in interrupt context, and a missed deadline is counted as an overrun. Each cycle:
1. debounces push button B1 (30 ms) and advances the fault-injection mode on each press;
2. samples the potentiometer (12-bit ADC, 92.5-cycle sampling time) and filters it with an 8-sample moving average;
3. scales the value to 0–250.0 km/h and sends frame 0x100 protected by the E2E module;
4. every tenth cycle sends frame 0x101;
5. runs the bus-off recovery state machine and the status LED.

Sampling time. The potentiometer wiper has a source impedance of up to 2.5 kΩ (two 5 kΩ halves in parallel). With a sample capacitor of about 5 pF, reaching 12-bit accuracy needs roughly ten time constants, about 120 ns, which the default 2.5-cycle sampling time at 42.5 MHz (59 ns) does not provide. 92.5 cycles (2.2 µs) gives a large margin at negligible cost, since only one sample is taken every 10 ms.

Fault injection. Button B1 cycles through three modes: NONE; SILENT, which stops frame 0x100 so that the receiver’s timeout detection is exercised; and OUT_OF_RANGE, which sends 300.0 km/h. The status byte of 0x100 flags active fault injection so that injected faults can be told apart from real ones in a bus trace.

Bus-off recovery. On bus-off the FDCAN hardware sets CCCR.INIT. The driver waits 100 ms and then clears INIT, which starts the standard recovery sequence of 128×11 recessive bits. The delay prevents a faulty node from flooding the bus with error frames.

## 3.6 Control ECU Design

The Control ECU runs FreeRTOS [13] on the Cortex-M4. Figure 3.3 shows the data flow.

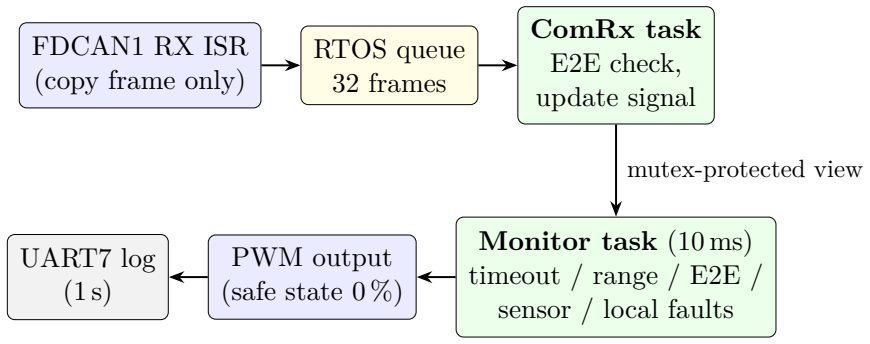
[picture p7: figure]
FDCAN1 RX ISR (copy frame only); RTOS queue 32 frames; ComRx task E2E check, update signal; Monitor task (10 ms) timeout / range / E2E / sensor / local faults; PWM output (safe state 0 %); UART7 log (1 s); mutex-protected view

Figure 3.3: Control ECU data flow

- Interrupt level. The FDCAN receive callback copies each frame into an RTOS queue and returns; a full queue is counted rather than blocking.
- ComRx task (above-normal priority) runs the E2E check on 0x100, updates a shared view of the sensor signal under a mutex and counts E2E outcomes. Frames 0x7E0 and 0x7DF are passed to the diagnostic module (ISO-TP and UDS). The task waits on the queue with a 2 ms timeout so that the ISO-TP and UDS timers also run when no frame arrives; all ISO-TP processing therefore happens in this single task.
- Monitor task (normal priority, 10 ms period with osDelayUntil) evaluates five faults, reports every result to the DTC manager, applies the safe state, runs bus-off recovery and prints a status line every second.
- Shared resources. Both tasks transmit on CAN (sensor frames in loopback and UDS responses); since the HAL function that fills the TX FIFO is not re-entrant, transmissions go through one mutex-protected function. A second mutex keeps log lines of the two tasks from interleaving, and the DTC manager is protected by its own mutex.

Table 3.5 lists the monitored faults. When a fault that invalidates the speed signal is active, the output is forced to 0 % instead of using stale or implausible data. The E2E fault heals only after ten consecutive valid frames to avoid chattering.

Table 3.5: Faults monitored by the Control ECU

Fault | Condition | Safe state

SPEED_TIMEOUT no valid 0x100 for more than 100 ms (500 ms grace after

| start) | yes
SPEED_RANGE | received speed above 250.0 km/h | yes
SPEED_E2E | CRC or sequence error; healed after 10 valid frames | yes
SENSOR_ADC | Sensor ECU reports an ADC read error in its status byte | no
OUTPUT_LOCAL | toggled by button USER1 (simulated actuator fault) | yes

Each fault is mapped to a DTC (Section 3.8).

## 3.7 Communication Modules

### 3.7.1 E2E protection

E2e_Protect() writes the 4-bit alive counter to byte 6 and the CRC-8 SAE-J1850 of bytes 0–6 to byte 7. E2e_Check() verifies the CRC first, so a corrupted frame never modifies the receiver state, and then classifies the counter difference modulo 16: 0 is repeated, 1 is OK, 2–3 is OK with some frames lost, and larger jumps are rejected as wrong sequence with resynchronisation on the next frame.

### 3.7.2 ISO-TP

The ISO-TP module keeps independent sender and receiver state machines per link. It is hardware independent: the CAN send function and a millisecond clock are injected through a configuration structure, which makes the timing behaviour fully controllable in unit tests. Notable design points:
- all frames are padded to 8 bytes with 0xCC;
- STmin is enforced with one extra tick of margin, because with a 1 ms clock a frame sent at x.99 ms and the next at (x + 1).00 ms would be only 0.01 ms apart;
- STmin values in the 100–900 µs range are rounded up to 1 ms, and reserved values are treated as the 127 ms maximum, as required by the standard;
- if the CAN driver is busy (three TX FIFO slots on the STM32), a frame is retried on the next cycle instead of being dropped;
- N_Bs and N_Cr timeouts, a limit on consecutive FC.WAIT frames and FC.OVFLW handling abort a transfer with an explicit result code.

## 3.8 Diagnostics Design

### 3.8.1 UDS server

The UDS server is a transport-independent function that takes a complete request and returns the response; the ISO-TP link of the Control ECU (request 0x7E0, response 0x7E8) and the functional address 0x7DF (single frames only) feed it. Table 3.6 lists the implemented services.

Table 3.6: Implemented UDS services

SID | Service | Supported parameters
0x10 | DiagnosticSessionControl | 01 default, 03 extended; response carries P2 = 50 ms and
| | P2* = 5 s
0x11 | ECUReset | 01 hard (core reset), 03 soft (new operation cycle); ex-
| | tended session only
0x14 | ClearDiagnosticInformation group 0xFFFFFF (all DTCs)
0x19 | ReadDTCInformation | 01 number of DTCs by status mask, 02 DTCs by status
| | mask
0x22 | ReadDataByIdentifier | 0xF195 software version, 0x0100 speed, 0x0101 active
| | faults; several DIDs per request
0x3E TesterPresent | 00, with suppress-positive-response bit

Design decisions:

- A non-default session falls back to the default session after 5 s without a request (S3 timer).
- ECU reset is only accepted in the extended session (NRC 0x7E otherwise), and it is executed only after the ISO-TP layer confirms that the positive response has been transmitted, so the tester always receives the answer.
- For functionally addressed requests the negative responses 0x11, 0x12, 0x31, 0x7E and 0x7F are suppressed, as ISO 14229 requires, so that ECUs which do not support a service stay silent on a broadcast.
- ReadDataByIdentifier skips unknown DIDs in a multi-DID request and answers NRC 0x31 only if none is known; a response that would not fit the buffer yields NRC 0x14.

### 3.8.2 DTC manager

The DTC manager keeps, for each DTC, the ISO 14229-1 status byte (Annex D) and a failure counter. Monitors report a result every cycle. A failed result sets testFailed, testFailedThisOperationCycle, pendingDTC and testFailedSinceLastClear; confirmedDTC is set once the configured number of consecutive failed results is reached, and a passed result resets the counter. At the start of an operation cycle pendingDTC is kept only if the test failed in the cycle that ended. The storage is RAM only; non-volatile storage and aging are future work. Table 3.7 gives the DTC mapping; the codes use the SAE J2012 layout (two-byte code plus failure type byte), and the mapping itself is project specific.

Table 3.7: DTC mapping of the Control ECU

Fault | DTC | Meaning | Confirm after
SPEED_TIMEOUT U0100-87 (0xC10087) | lost communication with Sen-
sor ECU, missing message

1

SPEED_RANGE | P0501-00 (0x050100) | vehicle | speed | sensor
range/performance

3

SPEED_E2E | U0400-81 (0xC40081) | invalid data received from
Sensor ECU

3

SENSOR_ADC | P0500-96 (0x050096) | speed sensor component in-
ternal failure

3

OUTPUT_LOCAL B1A00-11 (0x9A0011) output driver circuit short to ground (simulated)

3

### 3.8.3 On-target self-test

Unit tests cover the modules in isolation, but not their integration with the CAN controller, the RTOS tasks and the interrupt path. In loopback builds the Control ECU therefore instantiates a second ISO-TP link that plays the tester (transmitting on 0x7E0, receiving on 0x7E8, with block size 2 and STmin 1 ms so that flow control is exercised). A small sequencer sends a fixed list of requests through the real FDCAN controller, compares each response with an expected prefix and logs PASS or FAIL. Steps can inject or remove the local fault, which makes the full chain from a monitor to a confirmed DTC observable over UDS.

## 3.9 Verification Strategy

Verification proceeds bottom-up:
1. Unit tests on a PC for all hardware-independent modules, using a fake CAN driver and a fake clock. Compiled with -Wall -Wextra -Wpedantic -Wshadow -Wconversion.
2. FDCAN internal loopback on each ECU, which exercises bit-timing configuration, filters, interrupts and the full software path without a transceiver.
3. Two-node bus with transceivers and fault injection (M4); a logic-analyser capture is planned.
4. On-target UDS self-test in loopback (M3), then system test with an external tester on the physical bus.
Each hardware test records the UART log as evidence, together with a pass criterion defined before the run.

# Chapter 4

# IMPLEMENTATION AND RESULTS

## 4.1 Development Environment

Table 4.1: Tools

Tool | Use
STM32CubeMX 6.18 | peripheral, clock and middleware con-
| figuration of both projects
STM32CubeIDE 2.2 / GNU Arm toolchain 14.3 | firmware build
STM32CubeProgrammer CLI | flashing the NUCLEO-G431RB over
| SWD
OpenSTLinux (kernel 6.6), remoteproc, SSH over USB loading and starting the M4 firmware
| on the DK1
MSYS2 GCC and GNU Make | host unit tests
Git / GitHub | version control; each verified mile-
| stone is tagged

The M4 firmware is deployed by copying the ELF file to /lib/firmware and writing to the remoteproc sysfs interface (Appendix B).

## 4.2 Unit Tests

The hardware-independent modules are tested on a PC with a minimal self-written test harness (no external framework), a fake CAN driver that records every transmitted frame and can simulate a busy driver, and a fake millisecond clock that only advances when a test says so. Table 4.2 summarises the suites.

Table 4.2: Unit test results

Suite | Tests Checks Scope
ISO-TP | 26 | 115 | SF/FF/CF/FC in both directions, padding, block size,
| | | STmin in ms and µs encoding, N_Bs and N_Cr timeouts,
| | | FC.WAIT limit, FC.OVFLW, receive buffer overflow, wrong
| | | sequence number, SF interrupting a segmented reception,
| | | sequence number wrap-around (200 bytes), driver-busy
| | | retry, and a 4095-byte end-to-end transfer between two links
| | | on a simulated bus
E2E | 8 | 58 | CRC-8 catalogue value ("123456789" → 0x4B), counter
| | | wrap 15→0, single-bit corruption, repeated frame, lost
| | | frames and resynchronisation, short frame
DTC manager | 11 | 35 | status bits after pass/fail, confirmation after consecutive
| | | failures with debounce reset, healing keeps history bits,
| | | operation-cycle rules for pendingDTC, clear, read by status
| | | mask, balanced lock callbacks
UDS server | 11 | 69 | every service with positive and negative responses, suppress-
| | | positive-response bit, S3 session timeout, multi-DID read,
| | | response-too-long, reset only in the extended session and
| | | only after the response, functional-addressing NRC suppres-
| | | sion
Total | 56 | 277 | all pass, 0 failures

The 4095-byte end-to-end test also checks the exact frame count: one first frame, 585 consecutive frames and 74 flow-control frames for a block size of 8. An error in the expected count found while writing this test (584 instead of 585 consecutive frames, because 4089 = 584 × 7 + 1) illustrates why such arithmetic belongs in automated tests rather than in comments. Similarly, one DTC test initially expected a DTC with status 0x00 to be reported for the mask 0xFF; ISO 14229 reports a DTC only if (status & mask) != 0, so the implementation was right and the expectation was corrected.

## 4.3 Milestone M1: Sensor ECU in Loopback

The Sensor ECU firmware was flashed with the STM32CubeProgrammer CLI and run in FDCAN internal loopback, where the controller receives its own frames. The pass criterion was: transmit rate as designed, every 0x100 frame received back, no dropped frame, no bus-off, and a stable ADC reading that follows the potentiometer. Figure 4.1 shows the log and Table 4.3 the results.


Figure 4.1: Sensor ECU log in FDCAN internal loopback (one line per second)

Table 4.3: Milestone M1 results

Check | Observation | Result
Transmit rate | +110 frames per second (100×0x100 + 10×0x101) | ✓
Loopback reception | rx100 +100 per second; rx = tx - 2 constant (two frames in
| flight when the log is printed) | ✓
Endurance | more than 59 000 frames, drop=0, busoff=0 | ✓
ADC | follows the potentiometer (0 to 104.8 km/h observed during the
| sweep); ±1–2 LSB at rest | ✓
Scaling | e.g. ADC 865 → 865 × 2500/4095 = 528 → 52.8 km/h | ✓
Fault injection (B1) not yet exercised on hardware | open

## 4.4 Milestone M2: Control ECU in Loopback

In loopback the Control ECU also plays the Sensor ECU: its monitor task sends an E2Eprotected 0x100 frame every 10 ms with a speed ramp from 0 to 250 km/h, so the whole chain from the FDCAN interrupt to the PWM output is exercised on the DK1 alone. Figure 4.2 shows the log and Table 4.4 the results.


Figure 4.2: Control ECU log on the STM32MP157 Cortex-M4 in FDCAN internal loopback

Table 4.4: Milestone M2 results

Check | Observation | Result
Reception | e2e ok +100 per second, rx = tx - 1 | ✓
E2E | 30 900 frames: 0 CRC, 0 lost, 0 repeated, 0 sequence errors | ✓
Signal freshness age = 10 ms (timeout threshold 100 ms) | ✓
Output | PWM tracks speed, e.g. 193.4 km/h → 77.3 % | ✓
Faults | timeout active at start-up, cleared automatically once data arrives;
no active fault afterwards

✓

RTOS | 0 queue overflows; 11 032 bytes of the 16 KB heap free | ✓

## 4.5 Milestone M3: UDS and DTC Management on the Control ECU

The UDS server, the DTC manager and an ISO-TP link were integrated into the Control ECU, and the on-target self-test described in Section 3.8 was run in FDCAN internal loopback. Listing 4.1 shows the log; the complete log is stored in the repository (docs/logs/m3_uds_selftest.log). All 14 steps passed on the first hardware run.

[TEST] | 1/14 TesterPresent | PASS
[TEST] | 2/14 ReadDID F195 (ECU sends FF+CF) | PASS
[TEST] | 3/14 ReadDID x4 (ECU receives FF+CF) | PASS
[TEST] | 4/14 Unknown service -> NRC 11 | PASS
[TEST] | 5/14 Unknown DID -> NRC 31 | PASS
[TEST] | 6/14 Reset in default -> NRC 7E | PASS
[TEST] | 7/14 Session extended | PASS
[TEST] | 8/14 Confirmed DTCs = 0 | PASS
[CTRL] fault OUTPUT_LOCAL | SET
[TEST] | 9/14 Confirmed DTCs = 1 | PASS
[TEST] 10/14 DTC list B1A00 -11 0x2F | PASS
[CTRL] fault OUTPUT_LOCAL | cleared

[TEST] 11/14 Clear all DTCs | PASS
[TEST] 12/14 Confirmed DTCs = 0 again | PASS
[CTRL] soft reset: new operation cycle
[TEST] 13/14 Soft reset | PASS
[TEST] 14/14 Session default | PASS
[TEST] UDS self-test finished: 14/14 passed
[CTRL] speed=249.5 km/h age=10ms pwm=99.8% | e2e ok=499 lost=0 crc=0 rep=0
seq=0 | faults=0x00 dtc=0 | rx=537 tx=538 busoff=0 qovf=0 uds=38
heap=9744
Listing 4.1: On-target UDS self-test on the Cortex-M4 (UART7 log, abridged)

Table 4.5: Milestone M3 results

Check | Observation | Result
Segmented transfers | 13-byte response from the ECU and 9-byte request to the
ECU, both with FF/CF and flow control

✓

Negative responses NRC 0x11 (unknown service), 0x31 (unknown DID), 0x7E (reset in default session)

✓

Fault to DTC | local fault injected → DTC B1A00-11 confirmed with status
0x2F (TF, TFTOC, PDTC, CDTC, TFSLC)

✓

Clear | 0x14 FFFFFF → no confirmed DTC | ✓
Sessions and soft reset extended session with P2/P2*, soft reset starts a new operation cycle

✓

No side effects | 38 diagnostic frames exchanged while sensor data kept
flowing: 0 E2E errors, 0 queue overflows; 9.7 KB heap free

✓

Hard reset (0x11 01) | cannot be exercised by a tester running on the same core | open

## 4.6 Milestone M4: Two-Node Bus with Fault Injection

### 4.6.1 Wiring

Table 4.6 lists the verified connections. Each transceiver module carries a 120 Ω terminator, so the bus measures about 60 Ω between CANH and CANL; both boards share a common ground.

Table 4.6: Verified bus wiring

Signal | NUCLEO-G431RB | SN65HVD230 STM32MP157D-DK1
FDCAN1_TX PA12, CN10 pin 12 | CTX | PA12, CN13 pin 9 (Arduino
D14)
FDCAN1_RX PA11, CN10 pin 14 | CRX | PA11, CN13 pin 10 (Arduino
D15)
Supply | 3V3 / GND (CN6) | 3V3 / GND | CN16 pin 4 / pin 6

### 4.6.2 Diagnosing the bus bring-up

The first power-up on the bus did not work, and the fault was located without an oscilloscope by reading the FDCAN status registers of both nodes (the Nucleo through the ST-LINK in hot-plug mode, the DK1 from Linux). The last error code (LEC) of the protocol status register was the key observable:
1. The Sensor ECU reported LEC = 3 (acknowledge error) with its transmit error counter at 128. A node only reaches the acknowledge slot if it has read back every bit it sent, so the path Nucleo → transceiver→ bus → transceiver→ Nucleo was proven; only an acknowledging receiver was missing.
2. On the DK1 the receive pin PA11, sampled 50 000 times per second from Linux, never went low while the Nucleo was retransmitting: no signal reached the DK1.
3. Swapping the two transceiver modules on the Nucleo reproduced LEC = 3 with the second module as well, so both modules were good and the fault was on the DK1 side. The DK1 wires were moved to the documented header pins (CN13 pins 9 and 10).
4. A cyclic status frame (0x200) was added to the Control ECU so that it also transmits. The DK1 then reported LEC = 3 too: each node read back its own frames, but neither received the other, which located the fault in the link between the two modules; the CANH/CANL wires had been removed during module testing.
5. After reconnecting, both nodes reported LEC = 5 (bit-0 error) and cycled through bus-off. To separate a polarity error from other causes, the DK1 controller was switched to bus-monitoring (listen-only) mode from Linux: it received the Sensor ECU frames with valid E2E checks, which proved the polarity correct. With stable connections the bus then ran without errors.
During this phase the Sensor ECU went through several hundred bus-off events and recovered from each automatically, which exercises requirement R8 on real hardware.

### 4.6.3 Fault injection test

Both logs were captured simultaneously for 65 s while the potentiometer was swept and button B1 of the Sensor ECU was used to inject faults. Table 4.7 summarises the run; the complete logs are in docs/logs/.

Table 4.7: Milestone M4: fault injection over the physical bus

Time | Sensor ECU | Control ECU
23–33 s | potentiometer sweep, 142–233 km/h | received speed and PWM follow
39.7 s | B1: SILENT, frame 0x100 stopped | 39.8 s: SPEED_TIMEOUT set, PWM
0 %, DTC U0100-87 confirmed
46.7 s | B1: | OUT_OF_RANGE, 300.0 km/h
sent

timeout cleared, SPEED_RANGE set, PWM 0 %, DTC P0501-00 confirmed
55.6 s | B1: back to normal | SPEED_RANGE cleared, PWM 64.5 %
again; confirmed DTCs retained
whole run 110 frames/s, no frame dropped | 100 frames/s, 0 CRC, lost or repeated
errors, 0 bus-off, 0 queue overflows

The timeout was reported one log line (100 ms resolution) after the Sensor ECU changed mode, consistent with the 100 ms timeout threshold. The DTC count stayed at three after all faults had healed: confirmed DTCs are kept until a tester clears them, as ISO 14229 requires. One of the three, U0400-81, was stored when the bus first came up: the Sensor ECU flushed three stale frames from its transmit FIFO with old alive counters, and the E2E check correctly classified them as out of sequence.

## 4.7 Milestone M5: External UDS Tester

The self-test of milestone M3 runs on the same core as the server and cannot exercise a reset. A small tester was therefore added to the Sensor ECU: it reuses the shared ISO-TP module (TX 0x7E0, RX 0x7E8), receives CAN frames through a ring buffer filled by the interrupt so that all ISO-TP processing stays in the main loop, and is driven by single-key commands on the ST-LINK virtual COM port. Table 4.8 lists the command sequences run over the physical bus; all 22 steps passed.

Table 4.8: Milestone M5: UDS from an external node

Key Sequence | Steps Observation
t | full test | 12/12 segmented request and response over the bus, NRC
0x11/0x31/0x7E, sessions, DTC read and clear
v | version and speed | 2/2 | speed read over UDS equals the speed the Sensor ECU
| | | publishes (161.4 km/h)
d | read DTCs | 1/1 | e.g. U0100-87 and U0400-81, status 0x2E (pending, con-
| | | firmed, test no longer failing) after the Sensor ECU was
| | | reflashed
f | functional 0x7DF | 2/2 | TesterPresent answered; unsupported service correctly
| | | silent
r | hard reset | 4/4 | positive response, restart, ECU answers again within 3 s

### 4.7.1 Hard reset on a core controlled by Linux

The first hard-reset attempt returned the positive response 0x51 and then the ECU never answered again. Linux still reported the M4 as running, but its tick counters were frozen and RCC_MP_GCR.BOOT_MCU read 0: NVIC_SystemReset() had reset the Cortex-M4, which then stayed held in reset, because in production mode the boot of the M4 is controlled by Linux, and Linux was not told that the core had reset itself. Since a UDS hard reset is meant to emulate a power cycle of the ECU application, it was reimplemented as a firmware restart: interrupts are disabled, the peripherals owned by the M4 (FDCAN, TIM1, TIM7, UART7) are reset through the RCC, the core returns to the main stack in privileged mode, and execution jumps to the reset vector, so that RAM, the RTOS and all drivers are initialised again. With this change the ECU restarts in well under 3 s and the sequence passes. Coordinating a true core reset with Linux (for example through the inter-processor communication controller) remains possible future work.

## 4.8 Static Analysis

All project-owned code (the portable modules in common/ and the application and MCAL layers of both ECUs) was analysed with cppcheck 2.21 and its MISRA C:2012 addon, using the real HAL, CMSIS and FreeRTOS headers for type information; vendor code and STM32CubeMX-generated headers are parsed but not reported. The script tools/static_analysis.sh makes the check reproducible and fails on any finding.
A first attempt reported many violations of rule 17.3 (implicit function declaration) and incomplete configuration messages. They were an artefact of the setup: the CMSIS headers stop with #error Unknown compiler unless the target compiler macros are defined, which silently hid every HAL declaration. After defining the GCC/ARM macros

and adding the CMSIS-RTOS2 include path, the analysis saw the real types. Table 4.9 summarises how the remaining findings were handled.

Table 4.9: Handling of the static-analysis findings

Rule | Category Resolution
12.2 | Required | fixed: 8-bit constant shifted by 8 in the UDS server,
| | cast to 16 bit first
10.8 | Required | fixed: composite expressions cast to a wider type (ISO-
| | TP and both applications)
17.7 | Required | fixed: unused return values of logging and mutex calls
| | cast to void
11.8 | Required | fixed: const no longer cast away for the MP1 HAL
| | transmit call (payload copied)
13.4, 17.8, 12.1, 15.4, 2.5 Advisory | fixed: HAL macros replaced by register writes, param-
| | eter no longer modified, parentheses, single loop exit
| | flag, unused macro used
15.5 | Advisory | deviation D1: early return for parameter checks
8.7, 2.5 | Advisory | deviation D2: public APIs of common/ used by a
| | separate analysis unit
8.9 | Advisory | deviation D3: file-scope module state, inspectable by
| | symbol from Linux
11.4 | Advisory | deviation D4: CMSIS register access, MCAL layer only
21.6, 17.1 | Required | deviation D5: printf/vprintf debug log, application
| | layer only
11.6 | Required | deviation D6: integer-to-pointer conversion of the vec-
| | tor table address for the software restart, one function

After these changes the analysis reports no findings. All unit tests still pass, and both firmwares were rebuilt and re-verified on the physical bus (100 frames/s, no E2E error). The deviation records are kept in docs/misra_deviations.md. The cppcheck addon covers the automatically decidable rules only; it is not a certified checker and does not replace a review.

## 4.9 Bring-up of the Control ECU

The first run of the Control ECU on the DK1 did nothing observable. No debugger connection to the M4 was available in production mode (the A7 owns the M4 reset), and the UART log was not yet readable. The firmware state was therefore inspected from Linux, which can read the M4 SRAM (aliased at 0x3002 0000) and all peripheral registers through /dev/mem; symbol addresses and structure offsets were taken from the ELF file with nm and gdb. Two independent defects were found.

### 4.9.1 Issue 1: missing SysTick handler

Observation. xSchedulerRunning = 1 and the current task was the idle task, but the FreeRTOS tick count xTickCount stayed at 0 and the HAL tick uwTick was frozen at 19. All application tasks were blocked waiting for a tick that never came.
Root cause. | STM32CubeMX generated USE_CUSTOM_SYSTICK_HANDLER_-
IMPLEMENTATION = 1, | which tells the CMSIS-RTOS2 layer not to define

SysTick_Handler because the interrupt file will. With TIM7 selected as HAL time base, however, the interrupt file contained no such handler. The symbol table showed SysTick_Handler as a weak alias of Default_Handler, an endless loop: the first RTOS tick trapped the CPU at the SysTick priority, which also blocked the TIM7 interrupt and froze uwTick.
Fix. The flag is overridden to 0 inside a USER CODE section of FreeRTOSConfig.h, which STM32CubeMX preserves on regeneration, so that cmsis_os2.c provides the standard handler. After the fix the symbol is a strong definition and the tick advances at 1 kHz.

### 4.9.2 Issue 2: FDCAN kernel clock stuck in a glitch-free multiplexer

Observation. After the first fix the tasks ran, but CCCR.INIT remained 1, no frame was transmitted and the HAL state was BUSY with no error code, meaning that HAL_FDCAN_-Start() had succeeded. Clearing INIT directly from Linux had no effect either, which pointed to a missing protocol clock rather than to the firmware.
Investigation. Register reads after a fresh Linux boot showed the state left by Linux (Table 4.10). The clock calibration unit of FDCAN1 was in bypass (CCFG.BCC = 1) and therefore not involved.

Table 4.10: FDCAN clock state left by Linux after boot

Register field | Value Meaning
RCC_FDCANCKSELR | 3 | FDCAN kernel clock taken from PLL4_R
RCC_PLL4CR.DIVREN | 0 | PLL4_R output disabled (unused by Linux)
RCC_OCENSETR.HSEKERON 0 | HSE kernel clock output not enabled
RCC_TZCR.TZEN | 1 | RCC in secure mode; oscillator disable register is secure-
| | only

Root cause. STM32 kernel clock multiplexers are glitch-free: a switch completes only while both the current and the new input are running [8]. The firmware switched the multiplexer from PLL4_R to HSE while PLL4_R was disabled, so the switch never completed and the FDCAN core was left without any clock. The hypothesis was confirmed experimentally: enabling PLL4_R for a few milliseconds from Linux immediately let INIT clear and frames flow; PLL4_R was then disabled again and FDCAN kept running from HSE.
Fix. CanDrv_PrepareKernelClock(), called before the HAL initialises FDCAN, sets the HSE kernel clock enable, temporarily enables the output of the currently selected PLL if it is off, switches to HSE, waits 1 ms, restores the PLL output exactly as Linux left it, and reads back the effective kernel frequency. The fix was verified after a fresh reboot with no manual register access: the firmware alone brought FDCAN up at 24 MHz.

### 4.9.3 Other observations

- FreeRTOS heap. The default 3 KB heap was too small for five tasks (three application tasks plus the idle and timer-service tasks) with newlib re-entrancy enabled; it was raised to 16 KB, of which 11 KB remain free.

- DLC encoding. The STM32MP1 HAL encodes the data length in bits 19:16 of the header word, whereas the STM32G4 HAL uses the plain byte count. A compile-time assertion in each driver guards against silently using the wrong encoding.
- HAL tick rate. In production mode the HAL tick driven by TIM7 runs at about 2 kHz, because the timer clock configured by Linux differs from the value assumed by STM32CubeMX. The application uses the FreeRTOS tick, which is correct; the HAL tick is an open point.

## 4.10 Resource Usage

Table 4.11: Memory footprint (Debug builds)

Firmware | Code | RAM Available
Sensor ECU (STM32G431) 31.6 KB | 2.5 KB 128 KB flash / 32 KB RAM
Control ECU (M4, -O0) | 76.5 KB 24.8 KB 128 KB code / 128 KB data SRAM

# Chapter 5

# DISCUSSION AND EVALUATION

## 5.1 Evaluation against the Requirements

Table 5.1 maps the results of Chapter 4 to the requirements of Table 3.1. A requirement is marked as met only if it was demonstrated on hardware or by an automated test.

Table 5.1: Requirement coverage

ID Evidence | Status
R1 Different kernel clocks and time-quanta counts on the two nodes; error-free exchange at 500 kbit/s on the physical bus (M4) | met
R2 M1: 100 + 10 frames per second | met
R3 E2E unit tests; M2: 30 900 frames checked | met
R4 M4: timeout detected within about 100 ms and out-of-range immediately, output forced to 0 %; E2E detection shown with stale frames | met
R5 Sensor ECU button B1 over the bus (M4); Control ECU local fault through the M3 self-test | met
R6 UDS over ISO-TP on 0x7E0/0x7E8 with NRCs: 22 unit tests, 14/14 on-target self-test, 22/22 steps from an external tester on the bus including hard reset | met
R7 Only MCAL files include the HAL; 34 PC unit tests on the shared modules | met
R8 Hundreds of bus-off events during bus bring-up, each recovered automatically | met

## 5.2 What Loopback Tests Do and Do Not Prove

Internal loopback validates a large part of the design: the controller configuration, the acceptance filters, the interrupt path, the frame packing, the E2E protection and the application logic. It does not validate the physical layer. In internal loopback the controller acknowledges its own frames, so an error in the transceiver wiring, the termination, or a mismatch in bit timing between the two nodes would stay invisible. The two ECUs deliberately use different kernel clocks and different numbers of time quanta; whether they interoperate is what milestone M4 then showed on the physical bus; a logic-analyser measurement of the bit time and sample point would complete the picture.

## 5.3 Lessons Learned

Generated code is part of the system under test. The SysTick defect came from STM32CubeMX output, not from application code. It was only found because the investigation did not stop at “the tasks do not run” but checked the symbol table: a weak symbol resolved to Default_Handler is a concrete, checkable fact. Putting the fix in a user section of the generated file keeps it across regeneration.

On a heterogeneous SoC the M4 inherits the clock tree of Linux. Code that works on a standalone MCU can fail on the STM32MP1 because peripherals assigned to the M4 still depend on clock settings chosen by Linux. The FDCAN defect was a consequence of a general hardware rule (glitch-free multiplexers need both inputs running) meeting a specific software state (an unused PLL output switched off). The clean longterm solution is to let Linux configure the FDCAN kernel clock through the device tree; the firmware-side switch with read-back is a pragmatic and verified workaround.

Testing the integration, not only the units. The unit tests showed that the UDS server and the DTC manager behave as specified in isolation. The on-target self-test added what they cannot show: that ISO-TP runs correctly from an RTOS task fed by an interrupt queue, that two tasks can share the CAN transmitter, and that a fault detected by the monitor is visible over UDS with the right status bits. Running the tester on the ECU itself made this possible before a second node exists.

Error counters as a measuring instrument. Without an oscilloscope, the CAN controller itself was the most informative instrument during the bus bring-up. An acknowledge error proves that a node reads back its own bits, a bit-0 error that the bus does not become dominant, and listen-only mode separates receiving from transmitting. Swapping modules between known-good positions then isolated each segment of the chain in a few minutes.

Debugging without a debugger. Reading M4 memory and peripheral registers from Linux through /dev/mem, guided by symbol addresses from the ELF file, proved to be an effective technique on this platform, and it also allowed hypotheses to be tested by writing registers (for example enabling PLL4_R to confirm the multiplexer theory) before changing any firmware.

Evidence before conclusions. Several intermediate hypotheses during bring-up were wrong: USB cables and adapters were suspected while simply re-seating the connectors resolved the connection problems, the clock calibration unit was suspected but found in bypass, and the role of the HSE kernel-clock gate could not be isolated because its disable register is secure-only. Recording which observations support each conclusion (Section 4.9) keeps the report honest about what was actually proven.

## 5.4 Limitations

- The bit timing on the bus has not been measured with a logic analyser; correctness is inferred from error-free operation.

- The external tester is a firmware tester on the Sensor ECU; a PC or Linux tester (SocketCAN, e.g. python-udsoncan) has not been used yet. The hard reset restarts the firmware, not the core.
- DTCs are kept in RAM only (no non-volatile storage, no aging).
- The HAL tick of the M4 runs at about twice the intended rate in production mode.
- The FDCAN clock is reconfigured by the M4 rather than by the Linux device tree.
- MISRA compliance is checked with the rule subset that cppcheck can decide; there is no certified checker and no manual review of the undecidable rules. The firmware has not been measured for worst-case execution time or interrupt latency.

# Chapter 6

# CONCLUSION AND FUTURE WORK

## 6.1 Conclusion

This report presented the design of a miniature automotive ECU network and the completion of its five milestones. A Sensor ECU on an STM32G431 publishes an end-toend protected speed signal at 500 kbit/s with the designed timing, and a Control ECU on the Cortex-M4 of an STM32MP157 receives it under FreeRTOS, checks it, supervises it for faults and drives a safe-state output. The protocol and service layers are portable and backed by 56 passing unit tests, including a full-length ISO-TP transfer. Both ECUs were verified on hardware in internal loopback with zero communication errors over tens of thousands of frames, and the Control ECU answers UDS requests, turns monitor results into DTCs with ISO 14229 status bits and lets a tester read and clear them, as shown by a 14-step on-target test. On the physical two-node bus, injected faults propagated from the Sensor ECU through CAN to the Control ECU, which reacted within its timing requirements and stored the expected DTCs, and an external UDS tester on the Sensor ECU read and cleared them over the bus and reset the Control ECU. A three-minute video of the complete fault-to-DTC-to-tester flow is available at https://www.youtube.com/watch?v=Ocq1K0BO8kM.
The most instructive part of the work was the bring-up of the Control ECU on a heterogeneous SoC, where two defects outside the application code, a missing interrupt handler in generated code and a clock multiplexer blocked by the clock state left by Linux, were located by reading the running firmware’s memory and registers from Linux and were fixed in a way that survives code regeneration and a cold boot.

## 6.2 Future Work

1. Bus measurement. Capture the bus with a logic analyser to measure the bit time and sample point of both nodes.
2. DTC persistence. Keep DTCs across power cycles (the M4 has no flash; storage through Linux or an external EEPROM) and add aging of confirmed DTCs.
3. Core reset. Coordinate a true Cortex-M4 reset with Linux (remoteproc) instead of the firmware restart.

4. Tester. A Python UDS client on Linux using SocketCAN, either through a USB-CAN adapter or the second FDCAN controller of the STM32MP157.
5. Quality. A fix for the HAL tick rate, moving the FDCAN clock configuration into the Linux device tree, and timing measurements (task execution times, interrupt latency).

# REFERENCES

[1] ISO 11898-1:2015 – Road vehicles – Controller area network (CAN) – Part 1: Data link layer and physical signalling, Geneva: International Organization for Standardization, 2015.
[2] ISO 14229-1:2020 – Road vehicles – Unified diagnostic services (UDS) – Part 1: Application layer, Geneva: International Organization for Standardization, 2020.
[3] ISO 15765-2:2016 – Road vehicles – Diagnostic communication over Controller Area Network (DoCAN) – Part 2: Transport protocol and network layer services, Geneva: International Organization for Standardization, 2016.
[4] CAN Specification Version 2.0, Robert Bosch GmbH, Stuttgart, 1991.
[5] Specification of SW-C End-to-End Communication Protection Library, AUTOSAR Classic Platform, document AUTOSAR_SWS_E2ELibrary, AUTOSAR. [Online]. Available: https://www.autosar.org/
[6] SAE J1850 – Class B Data Communications Network Interface, Source of the CRC-8 polynomial 0x1D used by AUTOSAR E2E Profile 1, SAE International.
[7] Layered Software Architecture, AUTOSAR Classic Platform, document AU-TOSAR_EXP_LayeredSoftwareArchitecture, AUTOSAR. [Online]. Available: ht tps://www.autosar.org/
[8] RM0436: STM32MP157 advanced Arm-based 32-bit MPUs – Reference manual, STMicroelectronics. [Online]. Available: https://www.st.com/
[9] UM2505: STM32G4 Nucleo-64 boards (MB1367) – User manual, STMicroelectronics. [Online]. Available: https://www.st.com/
[10] RM0440: STM32G4 Series advanced Arm-based 32-bit MCUs – Reference manual, STMicroelectronics. [Online]. Available: https://www.st.com/
[11] UM2637: Discovery kits with increased-frequency 800 MHz STM32MP157 MPUs – User manual, Rev. 4, STMicroelectronics. [Online]. Available: https://www.st.com/ (https://www.st.com/)
[12] SN65HVD23x 3.3-V CAN Bus Transceivers – Datasheet, Literature number SLOS346, Texas Instruments. [Online]. Available: https://www.ti.com/
[13] FreeRTOS. “FreeRTOS Real Time Kernel,” Accessed: Sep. 26, 2026. [Online]. Available: https://www.freertos.org/

# Appendix A

# Frame Layouts

All multi-byte values are big-endian. Bytes 6 and 7 of the cyclic frames are written by E2e_Protect() and checked by E2e_Check().

Table A.1: Frame 0x100 SENSOR_SPEED (DLC 8, 10 ms)

Byte Signal | Encoding
0–1 | VehicleSpeed unsigned, 0.1 km/h per bit, valid 0–2500
2–3 | AdcRaw | 12-bit raw ADC value (diagnostic)
4 | Status | bit 0: fault injection active; bit 1: ADC read error
5 | – | reserved, 0
6 | AliveCounter 0–15 in the low nibble, +1 per frame
7 | CRC | CRC-8 SAE-J1850 (poly 0x1D, init 0xFF, xor-out 0xFF) over bytes 0–6

Table A.2: Frame 0x101 SENSOR_ALIVE (DLC 8, 100 ms)

Byte Signal | Encoding
0 | NodeState | 0 = normal, 1 = fault injection
1–4 | Uptime | seconds since reset
5 | BusOffCount saturates at 255
6 | AliveCounter as above
7 | CRC | as above

## Example

A speed of 123.4 km/h with ADC value 2021, no status flags and alive counter 5 gives the bytes 04 D2 07 E5 00 00 05 CRC, where 0x04D2 = 1234 and 0x07E5 = 2021.

# Appendix B

# Build, Deployment and Diagnosis Procedures

## B.1 Host unit tests

cd tests
make | # builds and runs test_isotp and test_e2e
Listing B.1: Running the unit tests

On Windows the MSYS2 UCRT64 gcc and make must be on the PATH; the makefile detects MinGW and disables the undefined-behaviour sanitiser, which MinGW does not provide.

## B.2 Sensor ECU

The project in sensor_ecu/ is built in STM32CubeIDE and flashed through the on-board ST-LINK, for example:

STM32_Programmer_CLI -c port=SWD mode=UR -w Debug/sensor_ecu.elf -v -rst
Listing B.2: Flashing the NUCLEO-G431RB

The log is printed on the ST-LINK virtual COM port at 115200 baud, 8N1.

## B.3 Control ECU (Cortex-M4 on the DK1)

The DK1 boots Linux from the SD card with both BOOT switches ON. Connected to the PC through the USB-C OTG port, it exposes a network interface and is reachable at 192.168.7.1.

scp control_ecu_CM4.elf root@192.168.7.1:/lib/firmware/control_ecu.elf
ssh root@192.168.7.1
R=/sys/class/remoteproc/remoteproc0
echo control_ecu.elf > $R/firmware
echo start > $R/state | # "stop" to halt the M4
Listing B.3: Loading and starting the M4 firmware

The M4 log is printed on UART7 (Arduino connector D1 = TX, D0 = RX) at 115200 baud.

## B.4 Reading M4 memory and registers from Linux

The technique used in Section 4.9: find the address of a variable in the ELF file, translate the M4 SRAM address (0x1002 xxxx) to the physical alias seen by the A7 (0x3002 xxxx) and read it through /dev/mem.

arm-none-eabi-nm control_ecu_CM4.elf | grep -E " (xTickCount|hfdcan1)$"
arm-none-eabi-gdb -batch -ex "print/x (int)&hfdcan1.State - (int)&hfdcan1" control_ecu_CM4.elf
Listing B.4: Locating symbols and structure offsets

import mmap, os, struct
fd = os.open("/dev/mem", os.O_RDONLY | os.O_SYNC)
ram = mmap.mmap(fd, 0x10000 , mmap.MAP_SHARED , mmap.PROT_READ , offset=0 x30020000)
can = mmap.mmap(fd, 0x1000 , mmap.MAP_SHARED , mmap.PROT_READ , offset=0 x4400E000)
rd = lambda m, off: struct.unpack("<I", m[off:off + 4])[0] print("xTickCount =", rd(ram, 0x10025104 - 0x10020000))
print("FDCAN CCCR = 0x%08x" % rd(can, 0x18))
Listing B.5: Reading a 32-bit value from M4 SRAM or a peripheral (run on the DK1)

Peripheral registers of a stopped M4 may be unclocked; reading them then raises a bus error. Oscillator-disable registers of the RCC are secure-only when RCC_TZCR.TZEN = 1 and cannot be written from Linux.
