huydinhischanging/mini-automotive-ecu-uds/docs/report/main.tex

% Technical project report - Mini Automotive ECU Network with UDS Diagnostics
% Build: latexmk -xelatex main.tex   (XeLaTeX + biber)
\documentclass[a4paper,12pt]{report}
\setcounter{tocdepth}{2}
\PassOptionsToPackage{colorlinks=true,linkcolor=black,citecolor=black,urlcolor=blue,unicode}{hyperref}
\usepackage{geometry}
\geometry{a4paper, left=30mm, top=25mm, bottom=20mm, right=20mm}
\usepackage{amsfonts}
\usepackage{amsmath}
\usepackage{enumitem}
\usepackage{xcolor}
\usepackage[toc]{appendix}
\usepackage{graphicx}
\usepackage{mathtools}
\usepackage[labelfont=bf]{caption}
% ── Unicode font setup (XeLaTeX) ──────────────────────────────
\usepackage{fontspec}
\setmainfont{Latin Modern Roman}
\setsansfont{Latin Modern Sans}
\setmonofont{lmmono10-regular.otf}[
  Scale=MatchLowercase,
  ItalicFont=lmmono10-italic.otf,
  BoldFont=lmmonolt10-bold.otf,
  BoldItalicFont=lmmonolt10-boldoblique.otf
]
\usepackage[english]{babel}
\usepackage{csquotes}
\usepackage{float}
\usepackage{makecell}
\usepackage{ragged2e}
\usepackage{longtable}
\usepackage{booktabs}
\usepackage{subcaption}
\usepackage{placeins}
\usepackage{tocloft}
\makeatletter
\renewcommand{\@makeschapterhead}[1]{%
  \vspace*{10\p@}%
  {\parindent \z@ \raggedright \normalfont
   \interlinepenalty\@M
   \Huge \bfseries #1\par\nobreak
   \vskip 18\p@}}
\makeatother
\renewcommand{\cftfigfont}{\small}
\renewcommand{\cftfigpagefont}{\small}
\renewcommand{\cfttabfont}{\small}
\renewcommand{\cfttabpagefont}{\small}
\setlength{\cftbeforefigskip}{0pt}
\setlength{\cftbeforetabskip}{0pt}
\usepackage{tikz}
\usetikzlibrary{shapes.geometric, arrows.meta, positioning, fit, backgrounds, calc, decorations.pathreplacing}
\usepackage{listings}
\usepackage{microtype}
\usepackage{array}
\usepackage{multirow}
\usepackage{tabularx}
\usepackage{pifont}
\usepackage[style=ieee,backend=biber,sorting=none,doi=true,url=true,isbn=false]{biblatex}
\AtEndPreamble{%
  \ifundef{\abx@macro@volume+number}%
    {\newbibmacro*{volume+number}{}}%
    {}%
}
\addbibresource{reference.bib}
\usepackage{xurl}
\usepackage{hyphenat}
\usepackage{hyperref}
\newcommand{\cmark}{\ding{51}}
\newcommand{\xmark}{\ding{55}}
\newlist{tblitem}{itemize}{1}
\setlist[tblitem]{label=\textbullet, nosep, leftmargin=1.1em, itemsep=0pt, topsep=0pt, partopsep=0pt, parsep=0pt}
\newcommand{\reportimage}[4]{%
  \begin{figure}[H]
    \centering
    
    \caption{#3}
    \label{#4}
  \end{figure}
}
\usepackage{etoolbox}
\AtBeginEnvironment{figure}{\captionsetup{font=small}}
% ── Code listing style ────────────────────────────────────────
\definecolor{codebg}{RGB}{245,245,245}
\definecolor{codegreen}{RGB}{0,128,0}
\definecolor{codegray}{RGB}{128,128,128}
\definecolor{codeblue}{RGB}{0,0,200}
\lstdefinestyle{mystyle}{
  backgroundcolor=\color{codebg},
  commentstyle=\color{codegreen},
  keywordstyle=\color{codeblue}\bfseries,
  numberstyle=\tiny\color{codegray},
  stringstyle=\color{orange},
  basicstyle=\ttfamily\footnotesize,
  breakatwhitespace=false,
  breaklines=true,
  captionpos=b,
  keepspaces=true,
  numbers=left,
  numbersep=5pt,
  showspaces=false,
  showstringspaces=false,
  showtabs=false,
  tabsize=2,
  frame=single,
  rulecolor=\color{gray!40},
  language=C
}
\lstset{style=mystyle}
\microtypesetup{protrusion=true,expansion=false}
\setcounter{secnumdepth}{2}
\AtBeginDocument{%
  \renewcommand{\contentsname}{TABLE OF CONTENTS}%
  \renewcommand{\listfigurename}{LIST OF FIGURES}%
  \renewcommand{\listtablename}{LIST OF TABLES}%
}
\setlength{\emergencystretch}{6em}
\pretolerance=1000
\tolerance=2000
\Urlmuskip=0mu plus 1mu\relax
\raggedbottom
% ── TikZ styles shared by the diagrams ────────────────────────
\tikzset{
  box/.style={draw, rounded corners=3pt, align=center, font=\small, inner sep=5pt},
  node/.style={box, fill=blue!6, minimum width=3.6cm, minimum height=1.4cm},
  layer/.style={box, minimum width=9.5cm, minimum height=0.9cm},
  arr/.style={-{Stealth[length=2.2mm]}, thick},
}
\begin{document}
\input{before_main/title}
\clearpage
\tableofcontents{}
\clearpage
{\renewcommand{\addvspace}[1]{\vspace{2pt}}\listoffigures}
\addcontentsline{toc}{chapter}{LIST OF FIGURES}
\clearpage
{\renewcommand{\addvspace}[1]{\vspace{2pt}}\listoftables}
\addcontentsline{toc}{chapter}{LIST OF TABLES}
\clearpage
\input{before_main/abbreviations}
\clearpage
\input{before_main/abstract}
\clearpage
\input{tex/intro}
\input{tex/background}
\input{tex/design}
\input{tex/result}
\input{tex/discussion}
\input{tex/conclusion}
\printbibliography[title={REFERENCES}]
\addcontentsline{toc}{chapter}{REFERENCES}
\begin{appendices}
  \input{tex/appendix/appendix1}
  \input{tex/appendix/appendix2}
\end{appendices}
\end{document}
