huydinhischanging/mini-automotive-ecu-uds/control_ecu/CM4/Core/Src/main.c

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
/* Includes ------------------------------------------------------------------*/
#include "main.h"
#include "FreeRTOS.h"
#include "cmsis_os2.h"
#include "openamp.h"

/* USER CODE BEGIN Includes */
#include <stdio.h>
#include "can_drv.h"
#include "control_app.h"
/* USER CODE END Includes */

FDCAN_HandleTypeDef hfdcan1;

IPCC_HandleTypeDef hipcc;

TIM_HandleTypeDef htim1;

UART_HandleTypeDef huart7;

/* Definitions for defaultTask */
osThreadId_t defaultTaskHandle;
const osThreadAttr_t defaultTask_attributes = {
  .name = "defaultTask",
  .stack_size = 128 * 4,
  .priority = (osPriority_t) osPriorityNormal,
};
void SystemClock_Config(void);
static void MX_GPIO_Init(void);
static void MX_FDCAN1_Init(void);
static void MX_TIM1_Init(void);
static void MX_UART7_Init(void);
static void MX_IPCC_Init(void);
int MX_OPENAMP_Init(int RPMsgRole, rpmsg_ns_bind_cb ns_bind_cb);
void StartDefaultTask(void *argument);

/* USER CODE BEGIN 0 */
/* printf() -> UART7 (PE8 = Arduino D1) -> CH340 USB-serial adapter */
int __io_putchar(int ch)
{
  uint8_t c = (uint8_t)ch;
  (void)HAL_UART_Transmit(&huart7, &c, 1U, HAL_MAX_DELAY);
  return ch;
}
/* USER CODE END 0 */

/**
  * @brief  The application entry point.
  * @retval int
  */
int main(void)
{

  /* MCU Configuration--------------------------------------------------------*/

  /* Reset of all peripherals, Initializes the Flash interface and the Systick. */
  HAL_Init();

  if(IS_ENGINEERING_BOOT_MODE())
  {
    /* Configure the system clock */
    SystemClock_Config();
  }
  else
  {
    /* IPCC initialisation */
    MX_IPCC_Init();
    /* OpenAmp initialisation ---------------------------------*/
    MX_OPENAMP_Init(RPMSG_REMOTE, NULL);
  }

  /* USER CODE BEGIN SysInit */
  /* UART first, so every later step (and Error_Handler) can report. */
  MX_UART7_Init();
  printf("\r\n[CTRL] Control ECU boot (%s mode)\r\n",
         IS_ENGINEERING_BOOT_MODE() ? "engineering" : "production");

  /* Must precede MX_FDCAN1_Init(): see CanDrv_PrepareKernelClock(). */
  printf("[CTRL] FDCAN kernel clock: %lu Hz\r\n", (unsigned long)CanDrv_PrepareKernelClock());
  /* USER CODE END SysInit */

  /* Initialize all configured peripherals */
  MX_GPIO_Init();
  MX_FDCAN1_Init();
  MX_TIM1_Init();
  MX_UART7_Init();
  /* Init scheduler */
  osKernelInitialize();

  /* USER CODE BEGIN RTOS_MUTEX */
  /* add mutexes, ... */
  /* USER CODE END RTOS_MUTEX */

  /* USER CODE BEGIN RTOS_SEMAPHORES */
  /* add semaphores, ... */
  /* USER CODE END RTOS_SEMAPHORES */

  /* USER CODE BEGIN RTOS_TIMERS */
  /* start timers, add new ones, ... */
  /* USER CODE END RTOS_TIMERS */

  /* USER CODE BEGIN RTOS_QUEUES */
  /* add queues, ... */
  /* USER CODE END RTOS_QUEUES */

  /* Create the thread(s) */
  /* creation of defaultTask */
  defaultTaskHandle = osThreadNew(StartDefaultTask, NULL, &defaultTask_attributes);

  /* USER CODE BEGIN RTOS_THREADS */
  if (!ControlApp_Init())
  {
    Error_Handler();
  }
  /* USER CODE END RTOS_THREADS */

  /* USER CODE BEGIN RTOS_EVENTS */
  /* add events, ... */
  /* USER CODE END RTOS_EVENTS */

  /* Start scheduler */
  osKernelStart();

  /* We should never get here as control is now taken by the scheduler */

  /* Infinite loop */
  /* USER CODE BEGIN WHILE */
  while (1)
  {
    /* USER CODE END WHILE */

    /* USER CODE BEGIN 3 */
  }
  /* USER CODE END 3 */
}

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
/* USER CODE BEGIN Header_StartDefaultTask */
/**
  * @brief  Function implementing the defaultTask thread.
  * @param  argument: Not used
  * @retval None
  */
/* USER CODE END Header_StartDefaultTask */
void StartDefaultTask(void *argument)
{
  /* USER CODE BEGIN 5 */
  /* Infinite loop */
  for(;;)
  {
    osDelay(1);
  }
  /* USER CODE END 5 */
}

/**
  * @brief  Period elapsed callback in non blocking mode
  * @note   This function is called  when TIM7 interrupt took place, inside
  * HAL_TIM_IRQHandler(). It makes a direct call to HAL_IncTick() to increment
  * a global variable "uwTick" used as application time base.
  * @param  htim : TIM handle
  * @retval None
  */
void HAL_TIM_PeriodElapsedCallback(TIM_HandleTypeDef *htim)
{
  if (htim->Instance == TIM7)
  {
    HAL_IncTick();
  }
}

/**
  * @brief  This function is executed in case of error occurrence.
  * @retval None
  */
void Error_Handler(void)
{
  /* USER CODE BEGIN Error_Handler_Debug */
  printf("[CTRL] Error_Handler\r\n");
  /* USER CODE END Error_Handler_Debug */
}
#ifdef USE_FULL_ASSERT
/**
  * @brief  Reports the name of the source file and the source line number
  *         where the assert_param error has occurred.
  * @param  file: pointer to the source file name
  * @param  line: assert_param error line source number
  * @retval None
  */
void assert_failed(uint8_t *file, uint32_t line)
{
  /* USER CODE BEGIN 6 */
  /* User can add his own implementation to report the file name and line number,
     ex: printf("Wrong parameters value: file %s on line %d\r\n", file, line) */
  /* USER CODE END 6 */
}
#endif /* USE_FULL_ASSERT */
