huydinhischanging/mini-automotive-ecu-uds/control_ecu/control_ecu.ioc

Mcu.UserName=STM32MP157DACx
PA11.Signal=FDCAN1_RX
PA12.Signal=FDCAN1_TX
PA14.GPIO_Label=USER1
PA14.Signal=GPIO_Input
PE11.Signal=S_TIM1_CH2
PE7.Signal=UART7_RX
PE8.Signal=UART7_TX
PH0-OSC_IN.Signal=RCC_OSC_IN
PH1-OSC_OUT.Signal=RCC_OSC_OUT
