huydinhischanging/mini-automotive-ecu-uds/sensor_ecu/Core/Src/main.c

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
/* Includes ------------------------------------------------------------------*/
#include "main.h"

/* USER CODE BEGIN Includes */
#include <stdio.h>
#include "sensor_app.h"
#include "tester_app.h"
/* USER CODE END Includes */

ADC_HandleTypeDef hadc1;

FDCAN_HandleTypeDef hfdcan1;

TIM_HandleTypeDef htim6;

UART_HandleTypeDef huart2;

/* USER CODE BEGIN PV */
/* Set by TIM6 every 10 ms, consumed by the main loop. */
static volatile bool s_tick10ms = false;
static volatile uint32_t s_tickOverruns = 0U;
/* USER CODE END PV */

void SystemClock_Config(void);
static void MX_GPIO_Init(void);
static void MX_FDCAN1_Init(void);
static void MX_ADC1_Init(void);
static void MX_TIM6_Init(void);
static void MX_USART2_UART_Init(void);
/* USER CODE BEGIN 0 */
/* Timer ISR only raises a flag; the real work (ADC, CAN, printf) runs in the
 * main loop so the interrupt stays short and nothing blocks inside it. */
void HAL_TIM_PeriodElapsedCallback(TIM_HandleTypeDef *htim)
{
  if (htim->Instance == TIM6)
  {
    if (s_tick10ms)
    {
      s_tickOverruns++;   /* previous 10 ms task has not finished yet */
    }
    s_tick10ms = true;
  }
}

/* printf() -> USART2 -> ST-LINK virtual COM port (115200 8N1) */
int __io_putchar(int ch)
{
  uint8_t c = (uint8_t)ch;
  (void)HAL_UART_Transmit(&huart2, &c, 1U, HAL_MAX_DELAY);
  return ch;
}
/* USER CODE END 0 */

/**
  * @brief  The application entry point.
  * @retval int
  */
int main(void)
{

  /* MCU Configuration--------------------------------------------------------*/

  /* Reset of all peripherals, Initializes the Flash interface and the Systick. */
  HAL_Init();

  /* Configure the system clock */
  SystemClock_Config();

  /* Initialize all configured peripherals */
  MX_GPIO_Init();
  MX_FDCAN1_Init();
  MX_ADC1_Init();
  MX_TIM6_Init();
  MX_USART2_UART_Init();
  /* USER CODE BEGIN 2 */
  if (!SensorApp_Init())
  {
    Error_Handler();
  }
  TesterApp_Init();
  if (HAL_TIM_Base_Start_IT(&htim6) != HAL_OK)
  {
    Error_Handler();
  }
  /* USER CODE END 2 */

  /* Infinite loop */
  /* USER CODE BEGIN WHILE */
  while (1)
  {
    /* USER CODE END WHILE */

    /* USER CODE BEGIN 3 */
    if (s_tick10ms)
    {
      s_tick10ms = false;
      SensorApp_Task10ms();
      TesterApp_Task();
    }
  }
  /* USER CODE END 3 */
}

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
