huydinhischanging/mini-automotive-ecu-uds/sensor_ecu/Core/Inc/main.h

#define BTN_USER_Pin GPIO_PIN_13
#define BTN_USER_GPIO_Port GPIOC
#define LED_GREEN_Pin GPIO_PIN_5
#define LED_GREEN_GPIO_Port GPIOA
