huydinhischanging/mini-automotive-ecu-uds/(commit log)

2026-09-24 Sensor ECU: CubeMX project, MCAL drivers and cyclic CAN frames
    - NUCLEO-G431RB at 170 MHz from 24 MHz HSE, FDCAN1 500 kbit/s (SP ~88%)
    - MCAL: can_drv (filter, TX/RX, bus-off recovery), adc_drv, gpio_drv
    - sensor_app: 0x100 every 10 ms, 0x101 every 100 ms with alive counter
    and CRC-8 SAE-J1850; button-driven fault injection
    - Internal loopback mode for testing without a transceiver
2026-09-25 ISO-TP transport layer (ISO 15765-2) with host unit tests
    - common/isotp: SF/FF/CF/FC, block size, STmin (ms and us encoding),
    N_Bs/N_Cr timeouts, FC.WAIT limit, FC.OVFLW, driver-busy retry
    - Hardware independent: CAN send and ms clock injected via config
    - tests/: 26 unit tests incl. SN wrap-around and 4095-byte end-to-end
    transfer between two links on a simulated bus
2026-09-25 M1: Sensor ECU verified in FDCAN internal loopback
    - README: milestone section with UART log screenshot and results
    (110 frames/s, 59k+ frames with 0 drops / 0 bus-off, ADC +-1-2 LSB)
    - STM32CubeIDE project settings from first build
2026-09-25 Control ECU skeleton on STM32MP157 M4, shared E2E module
    - control_ecu: CubeMX project (FDCAN1 PA11/PA12, UART7, TIM1 PWM, FreeRTOS)
    - can_drv for MP1: selects HSE 24 MHz kernel clock before FDCAN init
    (Linux leaves PLL4_R), read-back with 74.25 MHz fallback timing,
    MP1 DLC encoding, configurable filters, bus-off recovery
    - control_app: ComRx task (ISR queue, E2E check) and 10 ms Monitor task
    (timeout / range / E2E / sensor ADC / local faults, safe-state PWM)
    - common/e2e: alive counter + CRC-8 protect/check shared by both ECUs,
    CAN matrix and CRC-8 moved to common/, linked into both CubeIDE projects
    - tests: 8 E2E unit tests; Makefile detects MinGW via the compiler
2026-09-25 Control ECU: fix FreeRTOS SysTick and FDCAN kernel clock on MP157
    Verified on the DK1 (fresh Linux boot, FDCAN internal loopback): 100
    frames/s received with 0 E2E errors, timeout fault clears, PWM follows speed.
    - SysTick: CubeMX sets USE_CUSTOM_SYSTICK_HANDLER_IMPLEMENTATION=1 but
    generates no SysTick_Handler when TIM7 is the HAL timebase; the first
    RTOS tick fell into Default_Handler. Override to 0 in the USER CODE
    section so cmsis_os2.c provides it.
    - FDCAN clock: Linux leaves the mux on PLL4_R with that output disabled
    and HSE's kernel output gated (HSEKERON=0). Kernel muxes are glitch-free
    and only switch while both inputs run, so FDCAN had no clock and never
    left INIT. En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
    [can_drv.c, control_ecu.ioc]
2026-09-26 M2: Control ECU verified in FDCAN internal loopback
    README milestone with UART log: 30 900 frames, 0 E2E errors, 0 queue
    overflows, PWM tracking speed.
2026-09-26 Technical report (LaTeX) for milestones M1-M2
    31-page interim report: background (CAN bit timing, ISO-TP, UDS, E2E,
    STM32MP1), system design, unit test and hardware results, analysis of the
    two Control ECU bring-up issues, requirement coverage and future work.
    Built with XeLaTeX + biber; PDF committed at docs/report/main.pdf.
2026-09-26 M3: UDS server and DTC manager on the Control ECU
    - common/uds: ISO 14229-1 server (0x10, 0x11, 0x14, 0x19 01/02, 0x22,
    0x3E), NRC 0x11/12/13/14/31/7E/7F, suppress-positive-response bit,
    functional-addressing NRC suppression, S3 timeout, reset executed only
    after the response is sent; 11 unit tests
    - common/dtc: DTC manager with ISO 14229 status bits, consecutive-failure
    confirmation, operation cycle, clear, read by status mask; 11 unit tests
    - control_ecu diag_app: ISO-TP link 0x7E0/0x7DF -> 0x7E8, DTC table for
    the five monitors, DIDs F195/0100/0101, soft and hard reset
    - On-target self-test in loopback: a tester ISO-TP link on the M4 runs 14
    UDS requests through FDCAN; 14/14 p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
    [control_app.c, control_app.h, diag_app.c, diag_app.h]
2026-09-26 Two-node CAN bus running (Sensor ECU <-> Control ECU)
    - Both firmwares switched from internal loopback to normal mode
    - New cyclic frame 0x200 CONTROL_STATUS (100 ms, E2E protected): active
    faults, confirmed DTC count, output duty - gives traffic in both directions
    - README: verified wiring table (Nucleo CN10 12/14, DK1 CN13 9/10)
    On hardware: Control ECU receives 100 frames/s with 0 CRC/lost/repeated
    errors and 0 bus-off; Sensor ECU receives 0x200 at 10 frames/s.
    [can_matrix.h, control_app.c, sensor_app.c]
2026-09-26 M4: two-node CAN bus with fault injection
    Sensor ECU (NUCLEO-G431RB) and Control ECU (STM32MP157 M4) on a physical
    bus through SN65HVD230 transceivers. 65 s simultaneous capture:
    - potentiometer sweep tracked by the Control ECU
    - SILENT: SPEED_TIMEOUT within ~100 ms, PWM 0 %, DTC U0100-87
    - OUT_OF_RANGE: SPEED_RANGE, PWM 0 %, DTC P0501-00
    - faults heal, confirmed DTCs retained; 0 E2E errors, 0 bus-off
    Report: M4 section incl. register-based diagnosis of the bus bring-up
    (ACK vs bit-0 errors, module swap, listen-only mode), requirements R1,
    R4, R5, R8 now met. Logs in docs/logs/.
2026-09-26 Report: fix two overfull tables (bit timing, memory footprint)
2026-09-26 Static analysis: cppcheck + MISRA C:2012 addon, no findings
    - tools/static_analysis.sh: analyses common/ and the App/MCAL layers of
    both ECUs with the real HAL/CMSIS/FreeRTOS headers (GCC/ARM macros
    defined so CMSIS does not stop with #error), fails on any finding
    - Fixed in code: 12.2, 10.8, 17.7, 11.8 (required) and 13.4, 17.8, 12.1,
    15.4, 2.5 (advisory); cppcheck variableScope and always-false condition
    - Five scoped deviations documented in docs/misra_deviations.md
    (15.5, 8.7/2.5 for common APIs, 8.9, 11.4 in MCAL, 21.6/17.1 for the
    debug log)
    - Unit tests pass; both firmwares rebuilt and re-verified on the bus
    - Report and README updated
    [can_drv.c, control_app.c, diag_app.c, io_drv.c, sensor_app.c]
2026-09-26 M5: external UDS tester on the Sensor ECU, hard reset via firmware restart
    - sensor_ecu tester_app: UDS client on the shared ISO-TP module (0x7E0 ->
    0x7E8), ISR ring buffer so ISO-TP runs in the main loop, single-key
    commands on the ST-LINK VCP (t d c v f r), DTC display in SAE J2012 form
    - MCAL uart_drv (non-blocking RX) and time_drv (ms tick) so the App layer
    does not call the HAL
    - 22/22 steps over the physical bus: segmented transfers both ways, NRCs,
    functional addressing (NRC suppression), DTC read/clear, hard reset
    - Hard reset: NVIC_SystemReset() leaves the MP157 Cortex-M4 held in reset
    (RCC_MP_GCR.BOOT_MCU = 0, Linux owns its boot). New SysDrv_Restart():
    disable IRQs, re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
    [diag_app.c, main.c, sensor_app.c, sensor_app.h, sys_drv.c, sys_drv.h, tester_app.c, tester_app.h]
2026-09-27 Control ECU: enable IPCC and OpenAMP (RPMsg remote) in CubeMX
    Groundwork for a UDS tester on the Cortex-A7 (Linux) side that reaches the
    UDS server over RPMsg instead of CAN.
    - IPCC owned by A7NS and M4, RX1/TX1 interrupts at priority 3
    (= configLIBRARY_MAX_SYSCALL_INTERRUPT_PRIORITY)
    - OpenAMP remote mode, shared memory 0x10040000 / 32 KB, 4 vring buffers,
    matching the default STM32MP157 device tree
    - resource table linked at .resource_table; USER CODE fixes (SysTick,
    FreeRTOS heap, FDCAN clock) preserved
    Builds without warnings. Not yet tested on the board.
    [control_ecu.ioc, main.c, openamp_conf.h]
2026-09-28 README: sync with current code (layout, tester, deviations, roadmap)
2026-11-01 tools: compile both firmwares with arm-none-eabi-gcc in check_all
    arm_compile_check.sh builds every App, Mcal and common source with the
    STM32CubeIDE toolchain and the defines and include paths of each .cproject.
    check_all.sh runs it after the unit tests and static analysis and skips it
    when no ARM compiler is installed. README lists the E2E fault injection modes
    as a roadmap item.
