huydinhischanging/mini-automotive-ecu-uds/(notices)

Notices in the files:
control_ecu/CM4/OPENAMP/openamp_conf.h:
Copyright (c) 2026 STMicroelectronics.
All rights reserved.
This software is licensed under terms that can be found in the LICENSE file
